balu-16/SeedGrant_Safety/client/assets/illustrations/onboarding-2.png

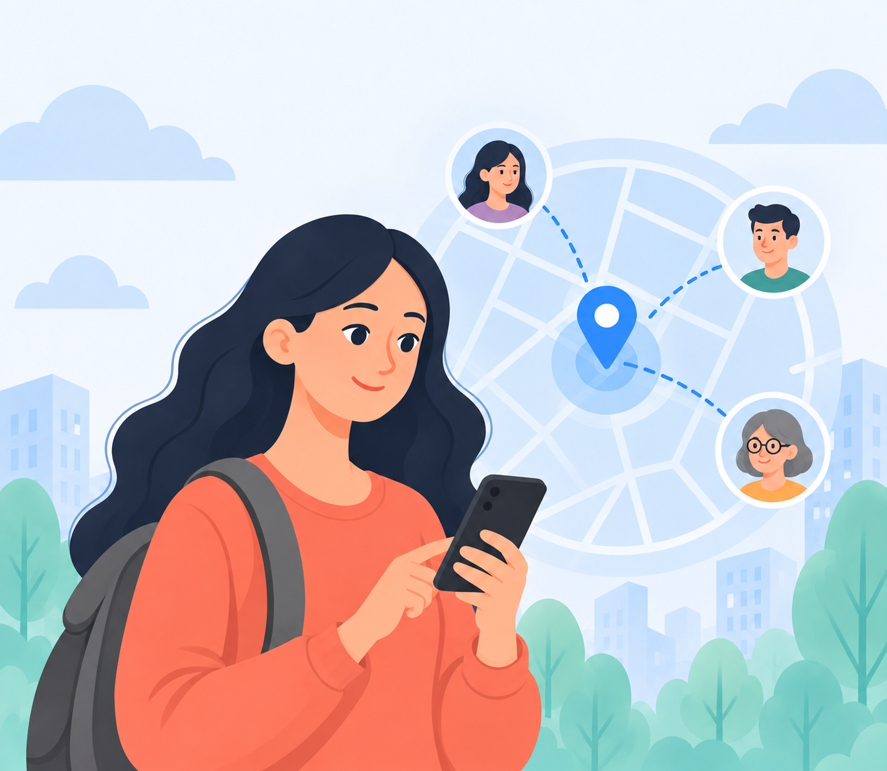
client/assets/illustrations/onboarding-2.png
