balu-16/SeedGrant_Safety/client/assets/illustrations/onboarding-1.png

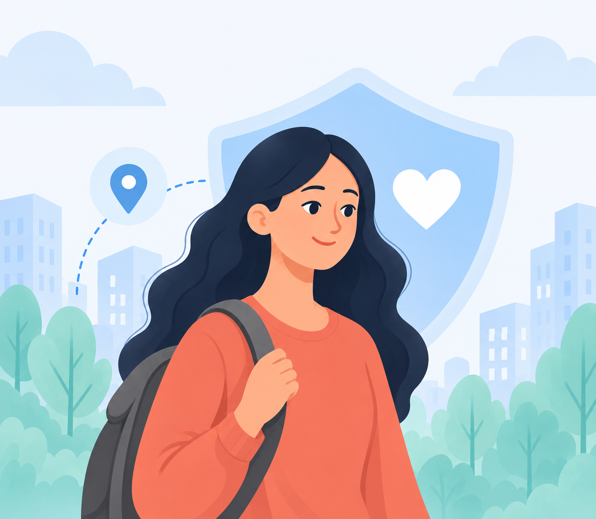
client/assets/illustrations/onboarding-1.png
