balu-16/SeedGrant_Safety/smart-safety-tag-v1/docs/design-inputs.md

# Smart Safety Tag V1 — Design Decisions

The editable KiCad design contains a 60 × 42 mm tag PCB and a 32 × 22 mm charging-adapter PCB. Both boards use two copper layers and 1.0 mm FR-4. The phone supplies location and Internet access. The tag provides BLE, audio capture, motion sensing, a physical SOS button, battery monitoring, RGB status and vibration.

| Function | Final selection | Electrical decision and manufacturer evidence |
| --- | --- | --- |
| MCU and BLE | ESP32-S3-MINI-1-N4R2 | 4 MB flash and 2 MB PSRAM. GPIO26 stays unused because it is reserved by this module option. The local land pattern uses the mechanically compatible ESP32-S2-MINI-1 name; the **symbol and fitted part are ESP32-S3**. [Espressif datasheet](https://documentation.espressif.com/esp32-s3-mini-1_mini-1u_datasheet_en.pdf). |
| PDM microphone | IM67D128BV01 | A switched TPS7A2030 provides 3.0 V. R5/R6 divide the clock into that supply domain. LR is grounded. Capture uses a 2.048 MHz PDM clock and 16 kHz mono PCM. [Infineon datasheet](https://www.infineon.com/assets/row/public/documents/24/49/infineon-im67d128b-datasheet-en.pdf). |
| Motion sensing | LIS2DW12TR | I²C address 0x18; CS high and SA0 low. INT1 and INT2 reach RTC-capable GPIOs. [ST datasheet](https://www.st.com/resource/en/datasheet/lis2dw12.pdf). |
| Battery | Akyga AKY1604 | Protected 400 mAh pack with Molex 51021-0200 lead; PCB connector is 53261-0271. Assembled pack envelope is 37.5 × 31 × 4.5 mm, excluding leads. Charge only within the pack's 0–45 °C range. Verify delivered connector polarity before attachment. [Pack specification](https://elektronik.ropla.eu/pdf/stock/aky/aky1604.pdf), [Molex connector](https://www.molex.com/en-us/products/part-detail/532610271). |
| Charger and power path | BQ25185DLHR | Standalone charger: R7 = 18 kΩ selects 4.2 V and 500 mA input limit; R8 = 2 kΩ sets 150 mA nominal charging. BAT feeds SYS when external power is absent. STAT1/STAT2 are discrete outputs. [TI datasheet](https://www.ti.com/lit/ds/symlink/bq25185.pdf). |
| 3.3 V regulator | TPS63802DLAR | Replaces TPS63031 to provide additional current margin. TPS63031 specifies up to 500 mA in boost operation; the design allocates a 500 mA rail test load. R18/R19 = 511 kΩ/91 kΩ set 3.308 V nominal. MODE defaults low for power saving and goes high while the microphone LDO is enabled. [TPS63031](https://www.ti.com/lit/ds/symlink/tps63030.pdf), [TPS63802](https://www.ti.com/lit/ds/symlink/tps63802.pdf). |
| Inductor | XFL4015-471MEC | 0.47 µH; the XFL4015-471 family appears in TI's recommended inductor table. [Coilcraft specification](https://www.coilcraft.com/getmedia/84927b8b-f089-421b-a7f4-a0fa23afe908/xfl4015.pdf). |
| Fuel gauge | MAX17048G+T10 | Connected to the protected BAT terminals, I²C address 0x36. The alert reaches GPIO5. SOC accuracy and low-battery thresholds require a discharge test with the fitted pack. [ADI datasheet](https://www.analog.com/media/en/technical-documentation/data-sheets/MAX17048-MAX17049.pdf). |
| SOS and status | KMR231GLFS; APFA3010LSEEZGKQBKC | SOS uses GPIO1, a 100 kΩ pull-up and 10 nF filtering, plus firmware debounce. Common-anode RGB uses active-low GPIO outputs and separate resistors. Check brightness through the enclosure. [Switch](https://www.ckswitches.com/media/1479/kmr2.pdf), [LED](https://www.kingbrightusa.com/images/catalog/spec/apfa3010lseezgkqbkc.pdf). |
| Vibration | VC0825B002F; TPS7A2030; AO3400A; PMEG2010EA,115 | Switched 3.0 V motor supply; 120 mA maximum starting-current allocation. Low-side MOSFET has a gate resistor and pull-down; the diode provides flyback protection. The motor is wired to M1 and mechanically retained. [Motor](https://www.vybronics.com/wp-content/uploads/datasheet-files/Vybronics-VC0825B002F-datasheet.pdf), [LDO](https://www.ti.com/lit/ds/symlink/tps7a20.pdf), [MOSFET](https://aosmd.com/res/data_sheets/AO3400A.pdf), [diode](https://assets.nexperia.com/documents/data-sheet/PMEG2010EA.pdf). |
| Contact protection | TPD1E10B06DYAR; PMEG6010CEH,115 | TPD1E10B06 replaces the proposed ESD5Z5.0T1G: its 5.5 V working range covers a normal 5 V ±5% source. The series Schottky blocks reversed charging polarity. Exposed-source short protection is on the adapter. [ESD device](https://www.ti.com/lit/ds/symlink/tpd1e10b06.pdf), [series diode](https://assets.nexperia.com/documents/data-sheet/PMEG6010CEH.pdf). |
| Charging adapter | USB4125-GF-A; TPS259530DSGR; Mill-Max 0900-1-15-20-75-14-11-0 | Separate 5.1 kΩ CC resistors; power-only USB-C. A 2.8 kΩ ILIM resistor sets approximately 0.754 A. The eFuse sits before the exposed pogo pins. Its overvoltage clamp is 5.45 V typical, 5.7 V maximum. [GCT drawing](https://gct.co/files/drawings/usb4125.pdf), [eFuse](https://www.ti.com/lit/ds/symlink/tps2595.pdf), [spring-pin catalog](https://www.mill-max.com/sites/default/files/external/catalog/2021-02/023-028.pdf). |

The exact passive order codes, voltage ratings and purchasing quantities are in the generated BOMs. Resistors are 1% Yageo RC0603 parts; capacitors are the listed TDK parts. Purchasing availability can change, so substitute parts require another voltage, capacitance, package and layout review.

C13 uses a 22 µF/16 V 1206 C3216X5R1C226M160AB. It replaces the initial 10 µF/25 V 0805 input capacitor after its manufacturer DC-bias curve showed insufficient derating margin near the charger's 4.5 V SYS rail. The larger capacitor's footprint fits the regulator area. The numerical allowance and remaining physical qualification are recorded in [power-budget.md](power-budget.md).

The battery-temperature circuit uses RT1 = B57332V5103A260, a 10 kΩ B3435 NTC, on the rear PCB face. **RT1 must be thermally bonded to the cell using an insulating interface that distributes pressure.** Its placement inside the battery envelope does not establish thermal contact. A TLV7042 window pulls CHG_OK low on a temperature fault, turns Q1 off and lets R16 drive charger /CE high. GPIO16 can also inhibit charging through Q2; it cannot override a hardware fault. The modeled corner check covers resistor/NTC tolerances, charger bias, supply variation, comparator offset and hysteresis. Open/short fault response and thermal lag still require measurements. [Comparator datasheet](https://www.ti.com/lit/ds/symlink/tlv7032.pdf).

The module antenna projects 3.75 mm beyond the board's top edge. Its all-layer copper, track, via and component keepout remains in the PCB. Keep the battery, metal clip and magnets outside that region. The bottom-port microphone uses the specified 0.4 mm unplated acoustic hole. Its enclosure needs an aligned acoustic opening and a suitable seal. The selected battery outline, lead exit, button travel, LED view, motor support, cell insulation and pogo compression must be checked in a physical enclosure mockup before freezing a wearable product.

The hardware supports continuous PDM capture while the MCU is awake. Keyword inference, phone emergency messaging and product firmware are separate from the included hardware-test application. Continuous keyword detection is **not available in deep sleep** in this design.
