balu-16/SeedGrant_Safety/client/assets/illustrations/PROMPTS.md

# Illustration generation

Built-in image_gen tool. Original reference images preserved in reference/. Card 2 received an anatomical correction before acceptance.

## prompt1

Use case: precise-object-edit. Create a standalone onboarding illustration asset from reference image 1 (SplashCard1); reference image 2 (SplashCard3) is the exact girl's identity and OPEN EYES reference. Output ONLY the illustrated scene, landscape ratio about 1.15:1, no phone frame, no UI, no branding, headings, buttons, or typography. Closely preserve the original soft clean 2D illustration, warm peach skin, long wavy dark navy hair, coral long sleeve top, gray backpack, pose holding shoulder strap, blue shield with white heart behind her, pale blue city and mint trees, location pin. Open both her eyes naturally, matching SplashCard3. REMOVE the black oval tag AND its metal clip from the bag/strap entirely; reconstruct a plain continuous gray backpack strap. No tag, tracker, hanging accessory, clip or keychain anywhere. Keep face identity, pleasant smile, hair, clothing and scene composition faithful. Pale near-white #F5F9FF background, full-bleed illustrated landscape with character ending at bottom edge, no white curved UI panel. High quality crisp asset for mobile.

## prompt2

Use case: precise-object-edit. Output a standalone mobile onboarding scene illustration ONLY, landscape ratio 1.15:1. Image 1 is SplashCard2 composition reference; image 2 is approved character identity, exact rendering style and open-eyes reference. Faithfully recreate the illustrated scene from card 2: same girl long wavy navy hair, warm peach skin, coral long-sleeve top, gray backpack, using black phone; pale blue circular street map behind her at right with blue location marker connected by dotted blue lines to three circular guardian portraits, mint trees and faint city, clouds. Open both girl's eyes naturally with exact style from image 2, looking at phone, retain pleasant smile. REMOVE black oval safety tag and all hanging clips/accessories from bag shoulder strap, restore plain gray continuous strap. Do not put a tag elsewhere. Preserve original pose/composition and character consistency. NO phone bezel, app text, logos, heading, buttons, status bar, footer, or UI panels. Near-white #F5F9FF background, crisp soft 2D editorial illustration, full-bleed scene, girl ends at bottom edge.

## prompt2fix

Precise-object-edit. Fix ONLY the anatomical defect in this illustration. The girl currently has three hands. REMOVE entirely the hand gripping the backpack shoulder strap and its forearm, reconstruct her coral shirt and plain uninterrupted gray backpack strap there. She must have EXACTLY TWO arms and TWO hands: one hand holding the black phone, the other index finger tapping the phone. Make their sleeves and arms connect anatomically naturally to her shoulders. Preserve her face, both open eyes, smile, navy hair, same coral clothing, backpack, map, guardians portraits, colors, soft illustration style, framing and every background detail. No tag, no clip, no hanging device. Output entire corrected standalone illustration.

## prompt3

Use case: precise-object-edit. Generate standalone illustration scene for onboarding card 3. Image 1 SplashCard3 is composition reference, image 2 is approved matching character/style reference. ONLY illustration, landscape 1.15:1, no phone bezel, app heading/branding/buttons/status bar/footer or UI panels. Same warm peach-skinned girl, long wavy dark navy hair, coral long sleeve shirt and gray backpack, open eyes looking at black phone and pleasant smile, exactly two anatomically correct arms/hands: holding phone and tapping. Faithfully preserve scene: pale blue city and mint trees, clouds; coral circular SOS symbol to right upper side, blue dotted lines connect it to three circular friendly guardian portraits on right, subtle coral alert rays. SOS is the only text. Remove black oval tracker tag AND metal clip completely from backpack strap, reconstruct plain gray strap. No device, accessory or clip attached to bag anywhere. Match reference 2's exact face, hair, rendering softness, palette, and clean 2D illustration style. Full-bleed near-white #F5F9FF background with character ending at bottom edge.
