balu-16/SeedGrant_Safety/client/assets/illustrations/SUPPORTING-PROMPTS.md

## Guardians hero

Create a standalone compact horizontal illustration asset from the GuardiansPage reference (image 1). Image 2 is exact approved main girl identity and style reference. Output only three friendly people waist-up as in GuardiansPage hero: navy-haired young man blue shirt left, main girl long wavy navy hair coral shirt center, young woman dark hair purple shirt right, arranged as a close trusted safety circle. All eyes open, main girl's face and rendering match image 2 exactly. Soft pale-blue shield-heart behind group, light blue clouds and very pale background #F5F9FF. Clean soft 2D illustration. Wide 2:1 crop, people fill central 75 percent of frame, bottom cropped at torso. No bag tags or device attachments. No typography, no slogans, no labels, no UI, no phone frame, no contact cards.

## Demo profile avatar

Create a standalone square profile avatar photograph inspired by the small profile photo in the attached UI reference. A fictional friendly young adult Indian woman, warm medium-brown skin, long dark brown hair, brown eyes open, natural smile, simple cream top. Head and shoulders centered, face large enough for a 48px circular avatar. Soft even studio lighting, plain light blue-gray background. Realistic photograph, clean polished professional profile portrait. ONLY portrait, no UI, text, border or phone frame.
