balu-16/SeedGrant_Safety/journal/ieee/figures/architecture.pdf

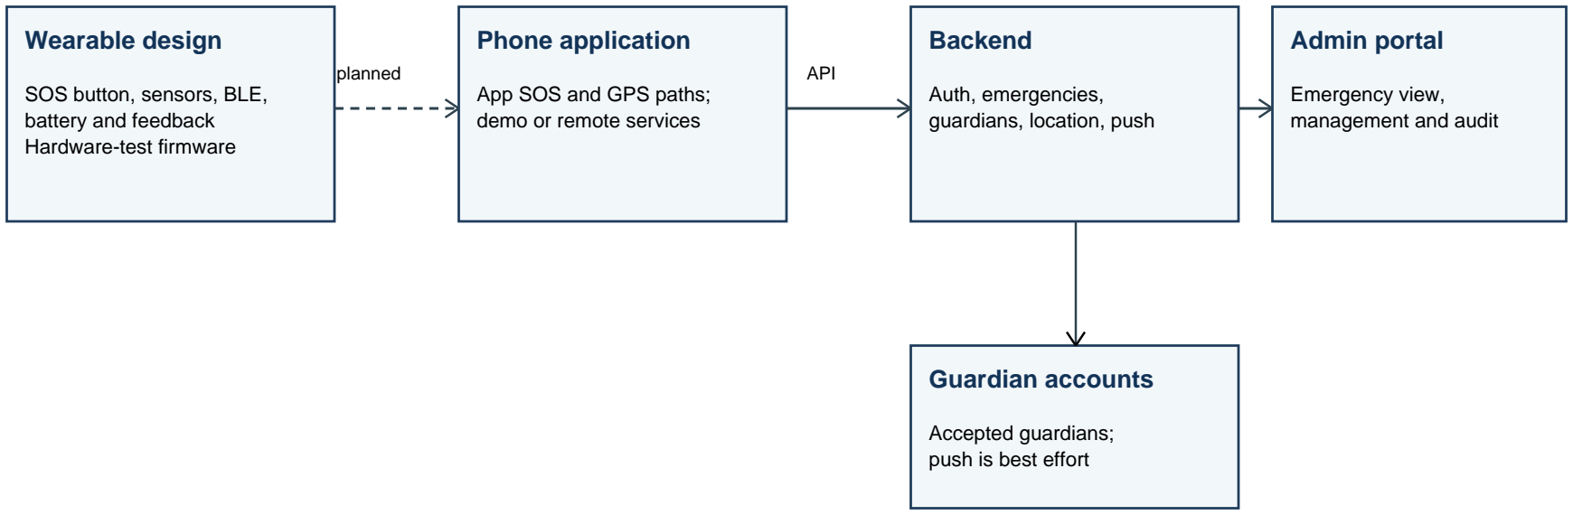
[picture p3: figure]
Wearable design; SOS button, sensors, BLE, battery and feedback Hardware-test firmware; Phone application; App SOS and GPS paths; demo or remote services; Backend; Auth, emergencies, guardians, location, push; Admin portal; Emergency view, management and audit; planned; API; Guardian accounts; Accepted guardians; push is best effort

Solid links: implemented software paths. Dashed link: intended integration, not implemented.
