balu-16/SeedGrant_Safety/patent/README.md

# Smart Safety Tag invention disclosure

`Patent.docx` is the editable document, copied and adapted from `/home/balarakeshg16/Documents/Projects/IDP_Project/Patent.docx`. `invention_disclosure.docx` is an identical copy retained for the earlier link, and `invention_disclosure.pdf` is its rendered PDF. The original IDP document has not been changed. The template's questions, tables, styles, headers, names, roll numbers, guide and signature images are preserved. Following the user's instruction, signature dates are set to 29.10.2026. Project-specific contributions and disclosure history remain for the team to confirm.

`adapt_reference.py` uses python-docx 1.2.0, the reference DOCX and the images in `figures/` to regenerate `Patent.docx`. `figures/make_figures.py` uses PyMuPDF to regenerate the diagrams; the other images are demo-mode app screenshots. The previous `create_docx.py`, `invention_disclosure.html`, and `architecture.png` are retained as superseded materials and should not be used to regenerate the current document.

The document is an invention disclosure rather than a patent application. Prior-art entries are preliminary and no patentability or formal similarity assessment is claimed.
