balu-16/SeedGrant_Safety/client/assets/illustrations/guardians.png

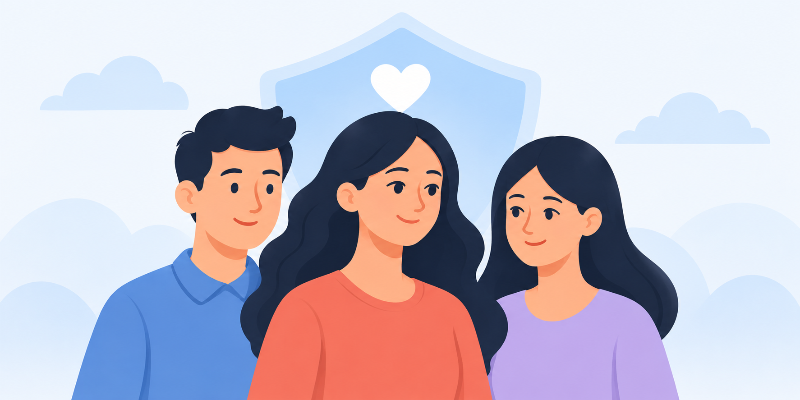
client/assets/illustrations/guardians.png
