balu-16/SeedGrant_Safety/client/assets/illustrations/onboarding-3.png

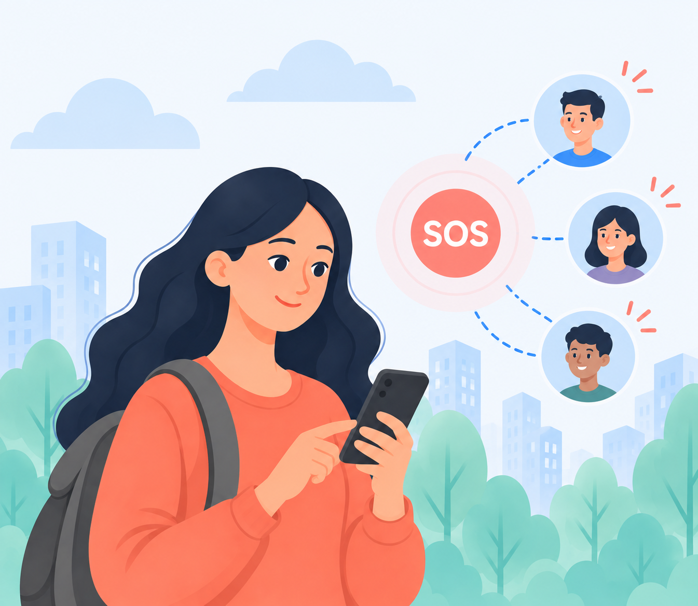
client/assets/illustrations/onboarding-3.png
