balu-16/SeedGrant_Safety/journal/ieee/figures/architecture.png

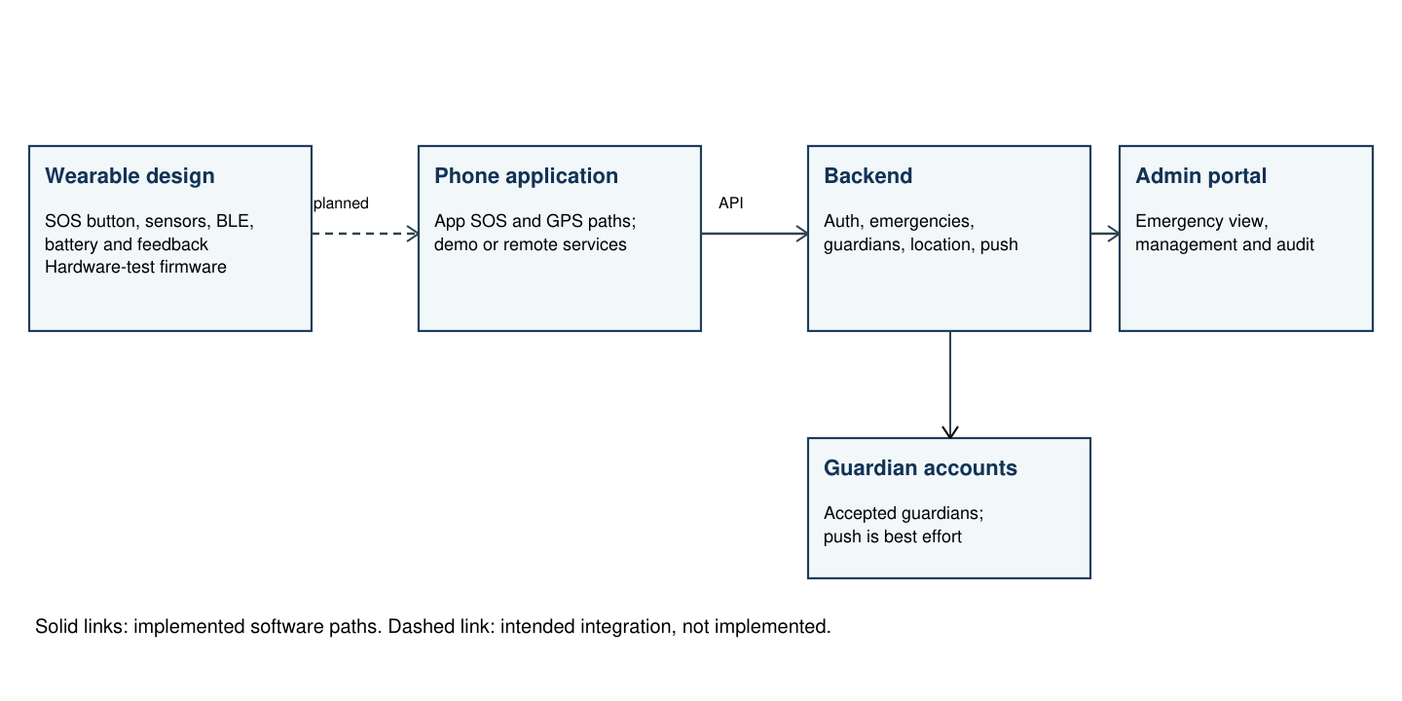
journal/ieee/figures/architecture.png
