balu-16/SeedGrant_Safety/patent/figures/fig1.png

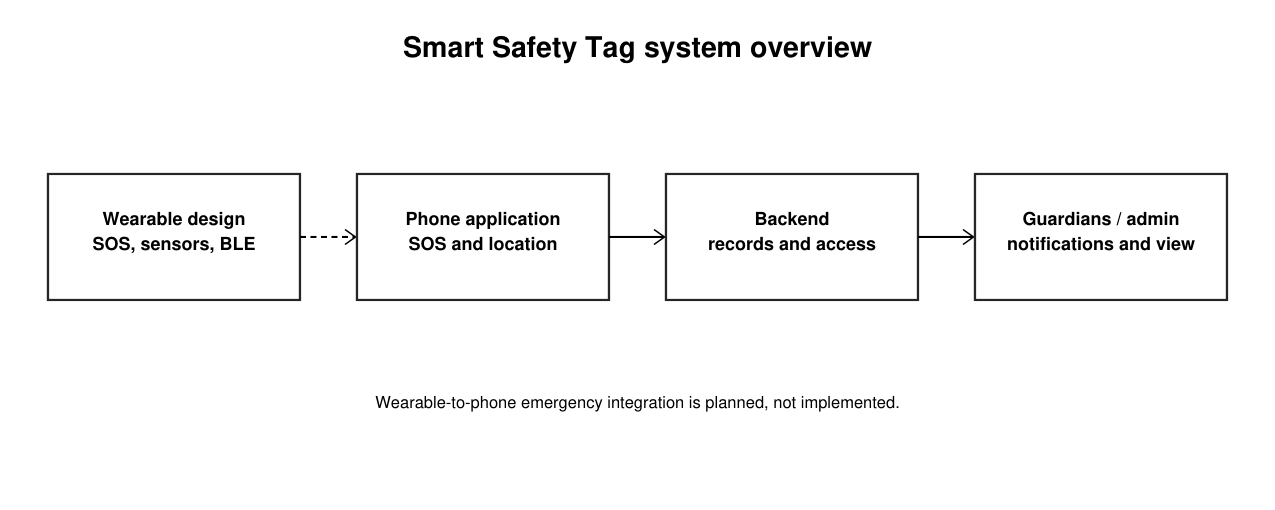
patent/figures/fig1.png
