balu-16/SeedGrant_Safety/patent/figures/guardians.png

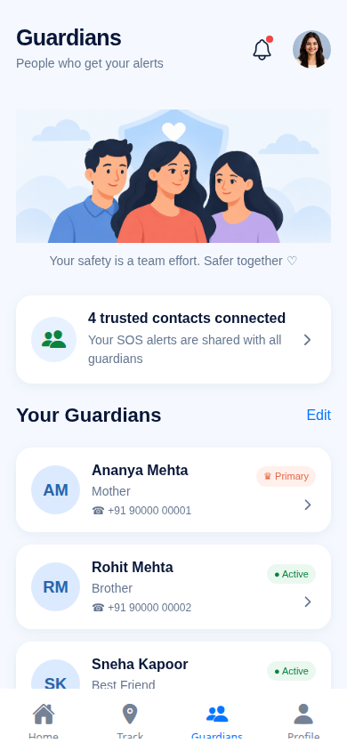
patent/figures/guardians.png
