balu-16/SeedGrant_Safety/patent/figures/home.png

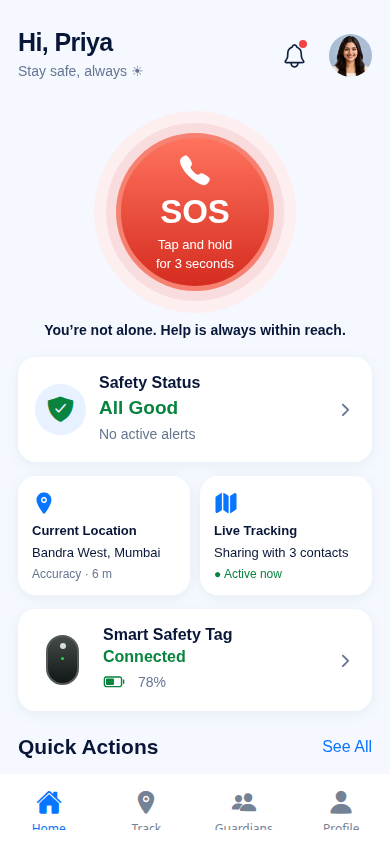
patent/figures/home.png
