balu-16/SeedGrant_Safety/patent/figures/login.png

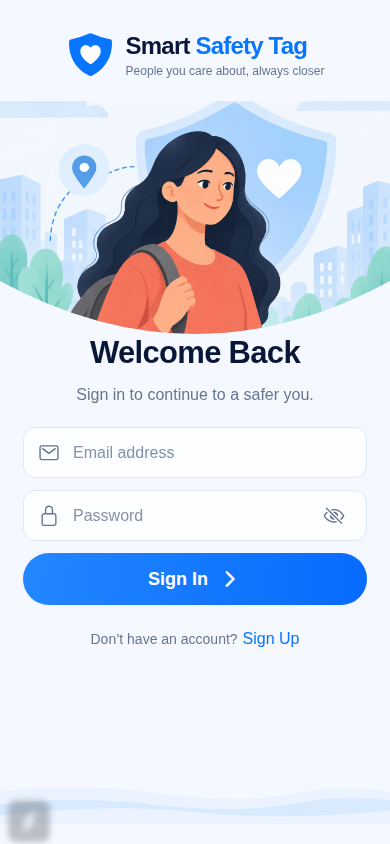
patent/figures/login.png
