balu-16/SeedGrant_Safety/patent/figures/signup.png

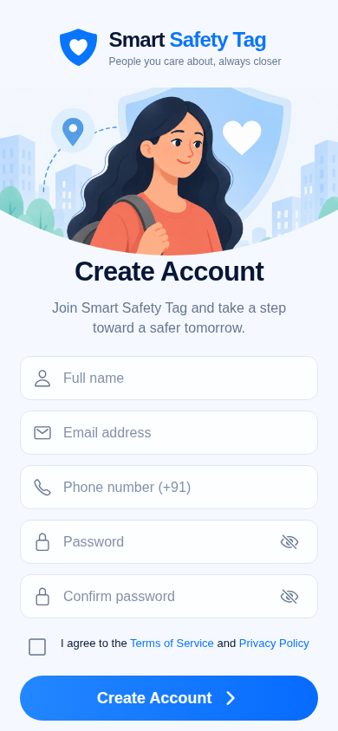
patent/figures/signup.png
