balu-16/SeedGrant_Safety/patent/figures/track.png

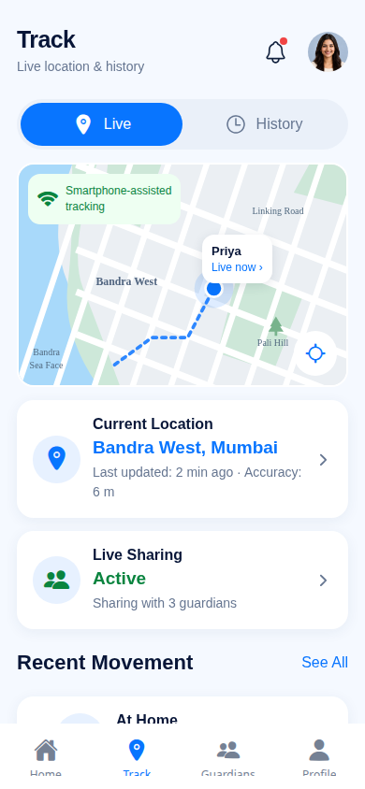
patent/figures/track.png
