balu-16/SeedGrant_Safety/reference/GuardiansPage.png

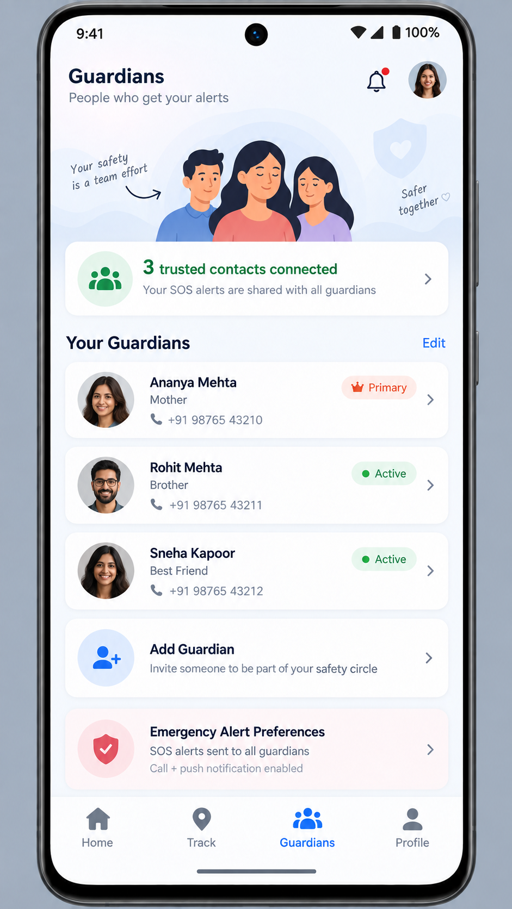
reference/GuardiansPage.png
