balu-16/SeedGrant_Safety/reference/HomePage.png

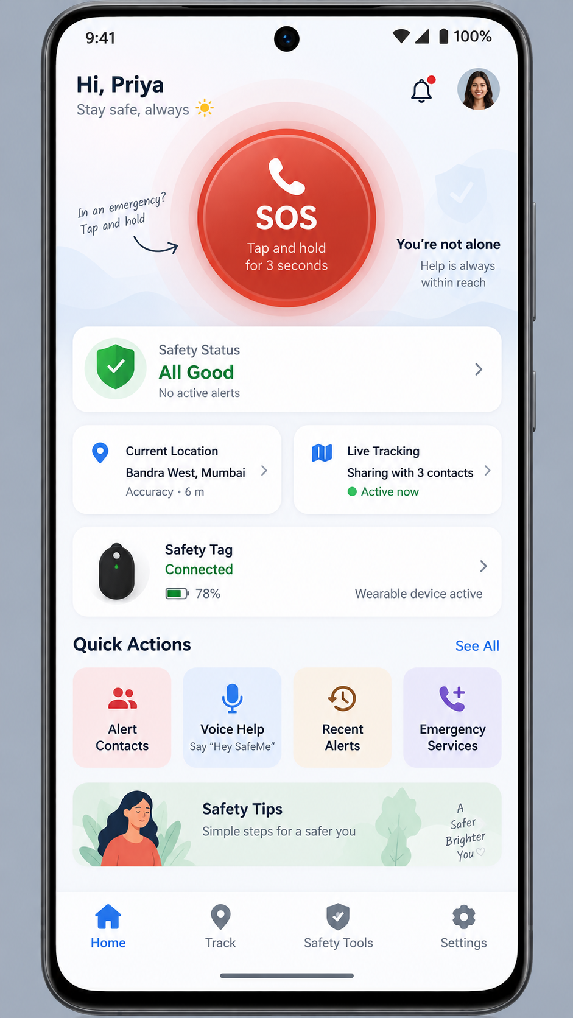
reference/HomePage.png
