balu-16/SeedGrant_Safety/reference/LoginPage.png

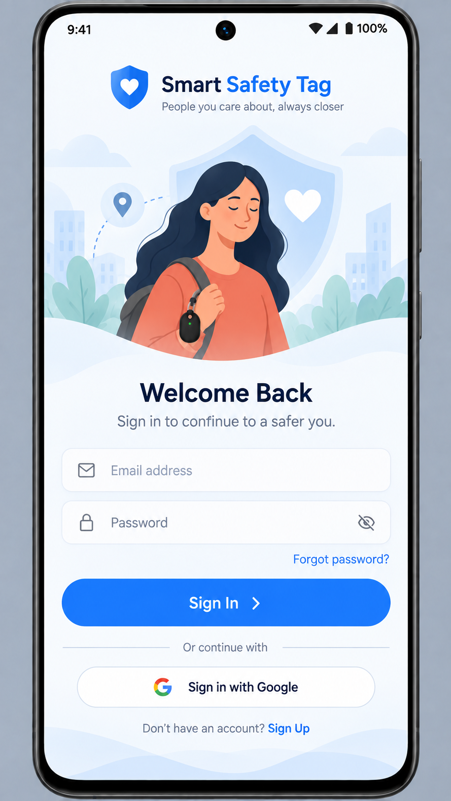
reference/LoginPage.png
