balu-16/SeedGrant_Safety/reference/ProfilePage.png

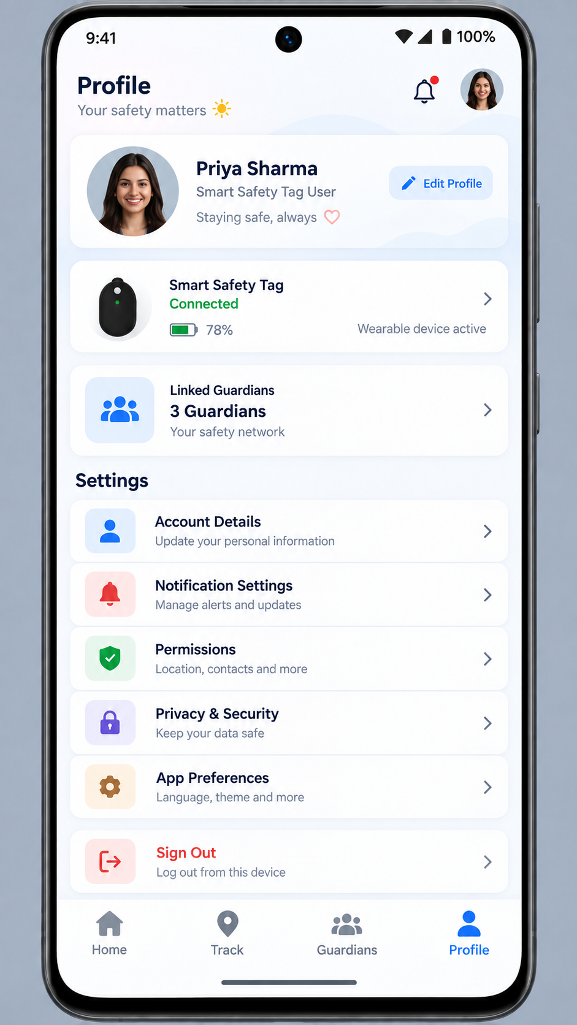
reference/ProfilePage.png
