balu-16/SeedGrant_Safety/reference/SignupPagee.png

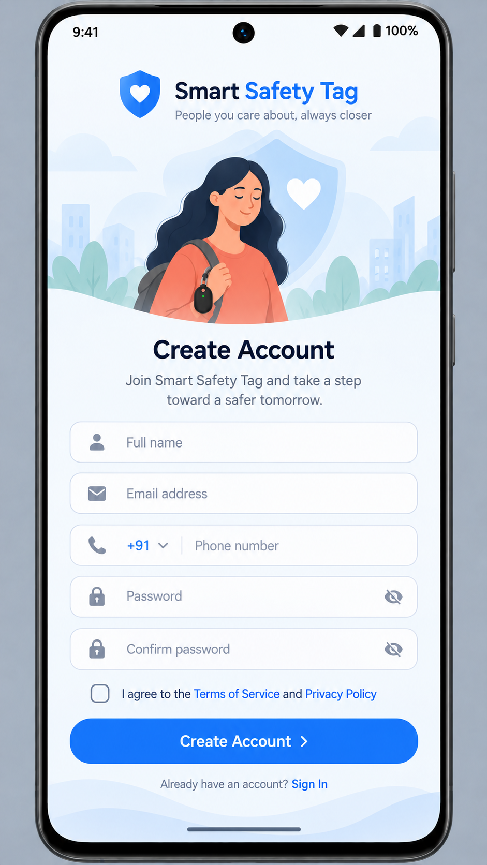
reference/SignupPagee.png
