balu-16/SeedGrant_Safety/reference/TrackPage.png

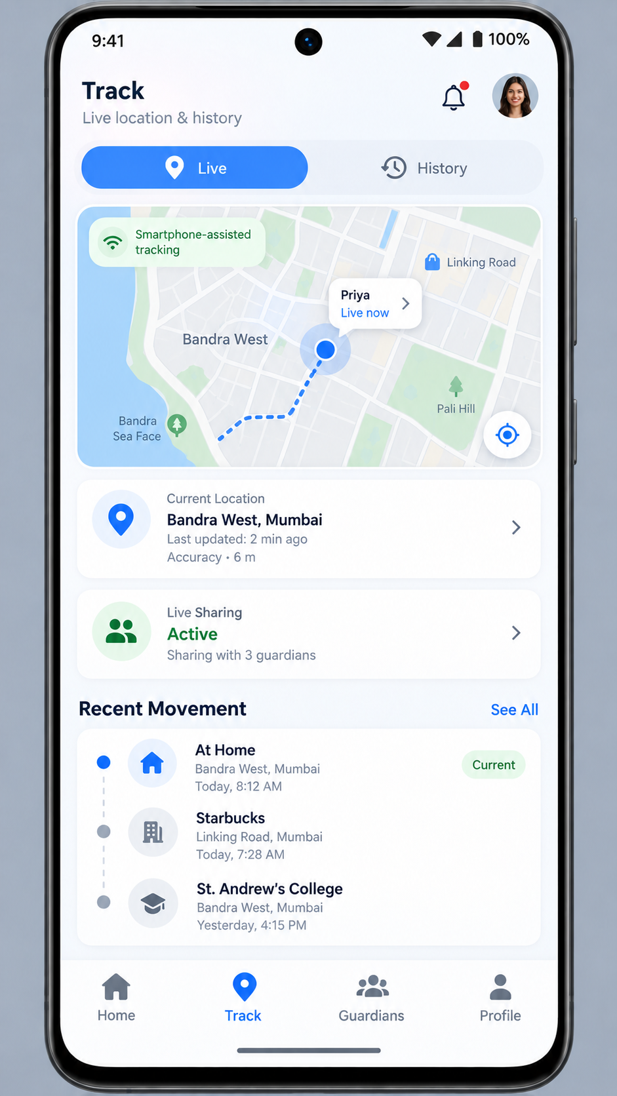
reference/TrackPage.png
