balu-16/SeedGrant_Safety/smart-safety-tag-v1/manufacturing/tag/bom/tag-bom.csv

References | Quantity | Manufacturer | Manufacturer Part Number | Value / Description | Package / PCB Footprint | Assembly | Manufacturer Source
BAT1 | 1 | Akyga | AKY1604 | Protected 400 mAh Li-polymer pack; Molex 51021-0200 lead | LP403035, cell 4.0 x 30 x 37 mm; assembled 4.5 x 31 x 37.5 mm | Attach to J1 after PCB electrical checks | https://elektronik.ropla.eu/pdf/stock/aky/aky1604.pdf
C1 C10 C13 C14 C15 | 5 | TDK | C3216X5R1C226M160AB | 22uF 16V X5R | Safety:C_1206_3216Metric | PCB placement | https://product.tdk.com/en/search/capacitor/ceramic/mlcc/info?part_no=C3216X5R1C226M160AB
C17 | 1 | TDK | C1608X7R1H103K080AA | 10nF 50V X7R | Safety:C_0603_1608Metric | PCB placement | https://product.tdk.com/en/search/capacitor/ceramic/mlcc/info?part_no=C1608X7R1H103K080AA
C19 | 1 | TDK | C1608X5R1A475K080AE | 4.7uF 10V X5R | Safety:C_0603_1608Metric | PCB placement | https://product.tdk.com/en/search/capacitor/ceramic/mlcc/info?part_no=C1608X5R1A475K080AE
C2 C7 C12 C16 C20 C23 | 6 | TDK | C1608X7R1H104K080AA | 100nF 50V X7R | Safety:C_0603_1608Metric | PCB placement | https://product.tdk.com/en/search/capacitor/ceramic/mlcc/info?part_no=C1608X7R1H104K080AA
C3 C4 C5 C6 C11 C18 C22 C25 C26 C27 | 10 | TDK | C1608X7R1C105K080AC | 1uF 16V X7R | Safety:C_0603_1608Metric | PCB placement | https://product.tdk.com/en/search/capacitor/ceramic/mlcc/info?part_no=C1608X7R1C105K080AC
C8 C21 C24 | 3 | TDK | C2012X5R1E106K125AB | 10uF 25V X5R | Safety:C_0805_2012Metric | PCB placement | https://product.tdk.com/en/search/capacitor/ceramic/mlcc/info?part_no=C2012X5R1E106K125AB
C9 | 1 | TDK | C1608X7R1E105K080AE | 1uF 25V X7R | Safety:C_0603_1608Metric | PCB placement | https://product.tdk.com/en/search/capacitor/ceramic/mlcc/info?part_no=C1608X7R1E105K080AE
D1 | 1 | Texas Instruments | TPD1E10B06DYAR | TPD1E10B06DYAR | Safety:D_SOD-523 | PCB placement | https://www.ti.com/lit/ds/symlink/tpd1e10b06.pdf
D2 | 1 | Nexperia | PMEG6010CEH,115 | PMEG6010CEH | Safety:D_SOD-123F | PCB placement | https://assets.nexperia.com/documents/data-sheet/PMEG6010CEH.pdf
D3 | 1 | Kingbright | APFA3010LSEEZGKQBKC | APFA3010LSEEZGKQBKC | Safety:LED_Kingbright_APFA3010_3x1.5mm_Horizontal | PCB placement | https://www.kingbrightusa.com/images/catalog/spec/apfa3010lseezgkqbkc.pdf
D4 | 1 | Nexperia | PMEG2010EA,115 | PMEG2010EA | Safety:D_SOD-323 | PCB placement | https://assets.nexperia.com/documents/data-sheet/PMEG2010EA.pdf
J1 | 1 | Molex | 53261-0271 | AKY1604 protected pack | Safety:Molex_PicoBlade_53261-0271_1x02-1MP_P1.25mm_Horizontal | PCB placement | https://www.molex.com/en-us/products/part-detail/532610271
L1 | 1 | Coilcraft | XFL4015-471MEC | 0.47uH 5.4A at 20% drop | Safety:L_Coilcraft_XFL4015 | PCB placement | https://www.coilcraft.com/getmedia/84927b8b-f089-421b-a7f4-a0fa23afe908/xfl4015.pdf
M1 | 1 | Vybronics | VC0825B002F | VC0825B002F | Safety:Motor_VC0825B002F | Wire to PCB pads | https://www.vybronics.com/wp-content/uploads/datasheet-files/Vybronics-VC0825B002F-datasheet.pdf
Q1 Q2 | 2 | Nexperia | BSS138P,215 | BSS138P | Safety:SOT-23 | PCB placement | https://assets.nexperia.com/documents/data-sheet/BSS138P.pdf
Q3 | 1 | Alpha & Omega Semiconductor | AO3400A | AO3400A | Safety:SOT-23 | PCB placement | https://aosmd.com/res/data_sheets/AO3400A.pdf
R1 R2 R6 R9 R10 R21 R22 | 7 | Yageo | RC0603FR-0710KL | 10k 1% | Safety:R_0603_1608Metric | PCB placement | https://www.yageogroup.com/component-documentation/download/specsheet/RC0603FR-0710KL
R11 | 1 | Yageo | RC0603FR-07432KL | 432k 1% | Safety:R_0603_1608Metric | PCB placement | https://www.yageogroup.com/component-documentation/download/specsheet/RC0603FR-07432KL
R12 | 1 | Yageo | RC0603FR-0724K9L | 24.9k 1% | Safety:R_0603_1608Metric | PCB placement | https://www.yageogroup.com/component-documentation/download/specsheet/RC0603FR-0724K9L
R13 | 1 | Yageo | RC0603FR-07365KL | 365k 1% | Safety:R_0603_1608Metric | PCB placement | https://www.yageogroup.com/component-documentation/download/specsheet/RC0603FR-07365KL
R14 | 1 | Yageo | RC0603FR-0749K9L | 49.9k 1% | Safety:R_0603_1608Metric | PCB placement | https://www.yageogroup.com/component-documentation/download/specsheet/RC0603FR-0749K9L
R15 R17 R20 R23 R28 | 5 | Yageo | RC0603FR-07100KL | 100k 1% | Safety:R_0603_1608Metric | PCB placement | https://www.yageogroup.com/component-documentation/download/specsheet/RC0603FR-07100KL
R16 | 1 | Yageo | RC0603FR-0747KL | 47k 1% | Safety:R_0603_1608Metric | PCB placement | https://www.yageogroup.com/component-documentation/download/specsheet/RC0603FR-0747KL
R18 | 1 | Yageo | RC0603FR-07511KL | 511k 1% | Safety:R_0603_1608Metric | PCB placement | https://www.yageogroup.com/component-documentation/download/specsheet/RC0603FR-07511KL
R19 | 1 | Yageo | RC0603FR-0791KL | 91k 1% | Safety:R_0603_1608Metric | PCB placement | https://www.yageogroup.com/component-documentation/download/specsheet/RC0603FR-0791KL
R25 R26 | 2 | Yageo | RC0603FR-07330RL | 330R 1% | Safety:R_0603_1608Metric | PCB placement | https://www.yageogroup.com/component-documentation/download/specsheet/RC0603FR-07330RL
R27 | 1 | Yageo | RC0603FR-07100RL | 100R 1% | Safety:R_0603_1608Metric | PCB placement | https://www.yageogroup.com/component-documentation/download/specsheet/RC0603FR-07100RL
R3 R4 | 2 | Yageo | RC0603FR-074K7L | 4.7k 1% | Safety:R_0603_1608Metric | PCB placement | https://www.yageogroup.com/component-documentation/download/specsheet/RC0603FR-074K7L
R5 R24 | 2 | Yageo | RC0603FR-071KL | 1k 1% | Safety:R_0603_1608Metric | PCB placement | https://www.yageogroup.com/component-documentation/download/specsheet/RC0603FR-071KL
R7 | 1 | Yageo | RC0603FR-0718KL | 18k 1% | Safety:R_0603_1608Metric | PCB placement | https://www.yageogroup.com/component-documentation/download/specsheet/RC0603FR-0718KL
R8 | 1 | Yageo | RC0603FR-072KL | 2k 1% | Safety:R_0603_1608Metric | PCB placement | https://www.yageogroup.com/component-documentation/download/specsheet/RC0603FR-072KL
RT1 | 1 | TDK | B57332V5103A260 | 10k B3435 1% | Safety:R_0603_1608Metric | PCB placement | https://www.tdk-electronics.tdk.com/en/530404/products/product-catalog/sensors-and-sensor-systems/smd-ntc-thermistors
SW1 | 1 | C&K | KMR231GLFS | SOS | Safety:SW_Push_1P1T-SH_NO_CK_KMR2xxG | PCB placement | https://www.ckswitches.com/media/1479/kmr2.pdf
U1 | 1 | Espressif | ESP32-S3-MINI-1-N4R2 | ESP32-S3-MINI-1-N4R2 | Safety:ESP32-S2-MINI-1 | PCB placement | https://documentation.espressif.com/esp32-s3-mini-1_mini-1u_datasheet_en.pdf
U2 | 1 | Infineon | IM67D128BV01 | IM67D128BV01 | Safety:Infineon_IM67D128BV01 | PCB placement | https://www.infineon.com/assets/row/public/documents/24/49/infineon-im67d128b-datasheet-en.pdf
U3 U9 | 2 | Texas Instruments | TPS7A2030PDBVR | TPS7A2030PDBVR | Safety:SOT-23-5 | PCB placement | https://www.ti.com/lit/ds/symlink/tps7a20.pdf
U4 | 1 | STMicroelectronics | LIS2DW12TR | LIS2DW12 | Safety:LGA-12_2x2mm_P0.5mm | PCB placement | https://www.st.com/resource/en/datasheet/lis2dw12.pdf
U5 | 1 | Texas Instruments | BQ25185DLHR | BQ25185DLHR | Safety:Texas_DLH0010A_WSON-10-1EP_2.2x2mm_P0.4mm_EP0.9x1.5mm | PCB placement | https://www.ti.com/lit/ds/symlink/bq25185.pdf
U6 | 1 | Texas Instruments | TLV7042DDFR | TLV7042DDFR | Safety:SOT-23-8 | PCB placement | https://www.ti.com/lit/ds/symlink/tlv7032.pdf
U7 | 1 | Texas Instruments | TPS63802DLAR | TPS63802DLAR | Safety:Texas_DLA0010A_VSON-10_2x3mm | PCB placement | https://www.ti.com/lit/ds/symlink/tps63802.pdf
U8 | 1 | Analog Devices | MAX17048G+T10 | MAX17048G+T10 | Safety:TDFN-8-1EP_2x2mm_P0.5mm_EP0.8x1.2mm | PCB placement | https://www.analog.com/media/en/technical-documentation/data-sheets/MAX17048-MAX17049.pdf
