balu-16/SeedGrant_Safety/smart-safety-tag-v1/docs/verification.md

# Smart Safety Tag V1 — Verification Register

CAD checks, calculations and firmware compilation are recorded separately from physical measurements. No assembled prototype was available for this design run. The current release is a prototype fabrication package.

| Check | Evidence | Result and limit |
| --- | --- | --- |
| Manufacturer pin/package review | Exact order codes and manufacturer links in [design-inputs.md](design-inputs.md), project-local symbols/land patterns and procurement BOMs | Design reviewed against the referenced package/pin information. Assembly inspection remains required; ERC cannot prove a manufacturer's pin mapping. |
| Tag schematic ERC | [hardware/tag/erc-report.txt](../hardware/tag/erc-report.txt) | KiCad 10.0.6, all severities: zero violations. Eight native child sheets plus the root. |
| Adapter schematic ERC | [hardware/charging-adapter/erc-report.txt](../hardware/charging-adapter/erc-report.txt) | KiCad 10.0.6, all severities: zero violations. |
| Tag PCB DRC/connectivity | [hardware/tag/routed-drc.json](../hardware/tag/routed-drc.json) | Zero violations, zero unconnected items, zero schematic parity findings after zone refill. 83 footprints. |
| Adapter PCB DRC/connectivity | [hardware/charging-adapter/routed-drc.json](../hardware/charging-adapter/routed-drc.json) | Zero violations, zero unconnected items, zero schematic parity findings after zone refill. 16 footprints. |
| Check coverage and exclusions | Native project settings and exported reports | All PCB DRC rule categories are enabled as errors or warnings, and no DRC item exclusions are recorded. There are no ERC item exclusions. KiCad's default ERC configuration ignores four diagnostics: single-use global labels, four-way junctions, SPICE model issues and symbol/footprint filter mismatch. The report explicitly lists these; zero ERC messages does not mean those categories were evaluated. |
| GPIO/module allocation | `python3 scripts/generate_gpio_header.py`; [GPIO map](gpio-map.md) | Twenty interface assignments match the actual ESP32-S3 module symbol's pad/GPIO names and central net definitions. Boot/reserved GPIO constraints are documented. |
| Thermal electrical model | `python3 scripts/check_thermal_window.py` | Modeled corners inhibit charging at 0 °C and 45 °C and permit it at 25 °C. Includes 1% resistors/NTC R25/beta, 36.5–39.5 µA TS bias, 4.25–5.10 V IN and TLV7042's maximum 8 mV offset/25 mV hysteresis. It does not establish actual threshold accuracy, thermal coupling, lag or fault behavior. |
| Battery/converter allocation | [power-budget.md](power-budget.md) | Nominal 3.308 V, 500 mA 3V3 test allocation, approximately 0.77 A discharge-end battery scenario and estimated runtimes. These are calculations/assumptions, not measured performance. |
| Power trace geometry | [power-routing.json](power-routing.json) and native PCB | Supply traces widened where pad/track clearance permits; narrower fanouts retained where necessary. Final DRC includes these widths. Actual rail loss, transient droop and heating require measurements. |
| Antenna/acoustic CAD provisions | U1 all-layer antenna keepout and U2 footprint/acoustic drill | Keepout retained with 3.75 mm antenna overhang; 0.40 mm unplated microphone opening retained. Battery/clip/magnet/enclosure effects remain unmeasured. |
| Fabrication specification | [manufacturing-specification.md](manufacturing-specification.md), PCB stackup and Gerber jobs | Two copper layers, 1.0 mm thickness and ENIG specified. The USB connector's 1.0 ±0.10 mm thickness constraint is included. Fabricator/assembler CAM review remains required. |
| Hardware-test firmware compilation | [prebuilt/build-record.json](../firmware/hardware-tests/prebuilt/build-record.json) | Successful ESP-IDF v5.5 build for ESP32-S3, GCC 14.2.0. Application image: 582,816 bytes; fits its 1,048,576-byte partition. Source and image SHA-256 hashes supplied. Not flashed to a tag. |
| Export/source correspondence | Manufacturing `manifest.json` for each board | Exact BOMs, Gerbers, drills, placement CSVs and assembly/schematic PDFs regenerated only after the strict checks pass. Manifests include hierarchical sheets, project settings and local libraries. |

The thermal model uses the beta equation and a simplified comparator uncertainty allowance; the actual comparator offset over the chosen low common-mode region, NTC temperature curve, bias accuracy, supply transients and hysteresis must be evaluated on the board. Conservative electrical thresholds can reduce the usable charging temperature window. RT1 must sense the cell through the specified insulating thermal bond.

Physical acceptance work is specified in [bring-up.md](bring-up.md): converter startup/ripple/load steps; capacitor effective capacitance/stability; battery/PCM peak load and cutoff; charge regulation/termination/power-path supplement; thermal lag and open/short NTC response; eFuse, contact reversal/short and ESD; motor startup/flyback; microphone audio quality; SOS/motion wake; BLE range/reconnect; SOC accuracy and runtime; and enclosure/clip/contact/acoustic fit. Record actual conditions and measurements here before changing any of those checks to passed.

The hardware-test firmware keeps the MCU awake. It provides PDM capture and standard BLE advertising, but does not contain an emergency keyword model, phone alert workflow, custom SOS GATT service or sleep/wake implementation. These behaviors and any safety performance claim remain outside the completed CAD/build checks.
