balu-16/SeedGrant_Safety/journal/ieee/REVISION_2_CHANGELOG.md

# Smart Safety Tag: second-pass revision

This pass starts from the previously revised manuscript. The earlier REVISION_CHANGELOG.md and REVISION.diff remain available; REVISION_2.diff compares the manuscript immediately before and after this pass.

## Diagnosis

The current prose was reviewed for repetition, generic explanations and uniform sentence patterns. This ranking is an editorial judgment, not a detector result:

1. **Verification and Discussion:** several paragraphs repeated the distinction between a software check and an integrated hardware trial. The revisions connect each limitation to the particular evidence or failure path it affects.
2. **Related Work, Introduction and Conclusion:** the opening comparison repeated prior systems and the paper's status. The revision organizes the comparison around where location and communication functions reside and restates the contribution in terms of the available evidence.
3. **Abstract, System Architecture and Wearable Design:** these sections already contained substantial project detail. Selected passages were revised to explain the SOS and location paths, the phone dependency and documented electrical choices more directly. Information-dense component and peripheral descriptions were retained where another rewrite would not improve them.

## Section-by-section changes

The percentages estimate the proportion of original prose sentences without an exact match in the corresponding revised section. Whitespace is normalized, and headings, figures, tables, captions, bibliography and author comments are excluded. Splitting or merging sentences affects these approximate figures. They are not similarity or AI-detection scores.

| Section | Approximate sentences changed | Change |
| --- | ---: | --- |
| Abstract | 89% | Reorganized the system, available checks and unimplemented functions into a direct account of the prototype. |
| Introduction | 91% | Explained the alert path and separated the functioning app from the wearable design. |
| Related Work | 69% | Compared on-device and phone-assisted communication, sensing and evidence boundaries. |
| System Architecture | 38% | Clarified when the client uses remote services, how a location fix affects the SOS request and how delivery attempts reach guardians. |
| Wearable Design | 30% | Emphasized the modeled charging window, current-based runtime assumptions and documented capacitor-selection trade-off. |
| Verification Method and Evidence | 75% | Connected each software, CAD and firmware check to the question it can answer and added examples of ignored ERC diagnostics from the project register. |
| Discussion and Limitations | 90% | Reorganized integration, notification, privacy and participant-related limitations around the actual alert path. |
| Conclusion | 67% | Restated the present evidence and next integration steps. |

The reason for replacing the input capacitor is supported by the [project power budget](../../smart-safety-tag-v1/docs/power-budget.md). The named ignored ERC diagnostic examples are supported by the [verification register](../../smart-safety-tag-v1/docs/verification.md). No new experimental results, measurements or references were added.

## Author input requested

The manuscript contains matching TODO(author) comments at the relevant passages:

1. Explain the team's reasons for choosing the phone-assisted alert path and any additional design constraints.
2. Check whether the broad statement about location and alert data revealing routines needs a separate citation.
3. Explain the practical reasons for a separate charging adapter, if documented.
4. Confirm the manufacturer evidence for the capacitor selection and whether it needs a direct citation.
5. Identify any documented software-testing failures or unexpected outcomes suitable for discussion.
6. Confirm whether physical integration or alert-path trials have taken place since the saved records.
7. Describe the intended participant group and consent procedure when a study protocol exists.
8. Explain any project constraints that prevented fabrication or physical validation, if appropriate for publication.

These comments request information; they are not claims of completed work. Affiliations and corresponding-author details also remain to be confirmed. The requested citation restrictions were observed, so the source questions above remain unresolved for author review.

## Verification

- pdfLaTeX, BibTeX and two further pdfLaTeX runs completed. The revised PDF has 10 pages, compared with 10 before this pass; its first page and verification and discussion pages were visually reviewed.
- The final build reports no overfull boxes, unresolved references or citation warnings. All five figures, three tables and 21 bibliography entries remain present.
- The 27 citation commands, 8 reference commands, 8 labels, 9 inline-math expressions, document preamble, all figure and table environments, bibliography and figure assets were checked against the preceding draft. Numeric literals were compared by section, and their associated statements were reviewed.
- The portable source archive contains the revised main.tex. No application code was changed; the software-test results described in the paper remain the previously recorded results.
- The supplied report's 83% is an AI-writing estimate for an earlier draft, not a text-similarity score. The detector was not run on this revision. The authors must rerun it themselves; no revised percentage or threshold is claimed.
