balu-16/SeedGrant_Safety/journal/ieee/figures/adapter_board.pdf

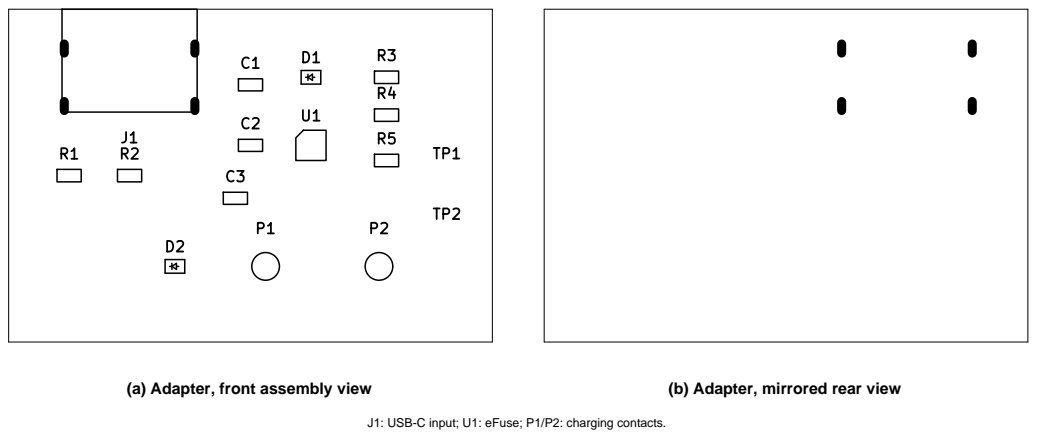
[picture p22: page 1]

J1: USB-C input; U1: eFuse; P1/P2: charging contacts.
