balu-16/SeedGrant_Safety/smart-safety-tag-v1/manufacturing/charging-adapter/assembly/charging-adapter-schematic.pdf

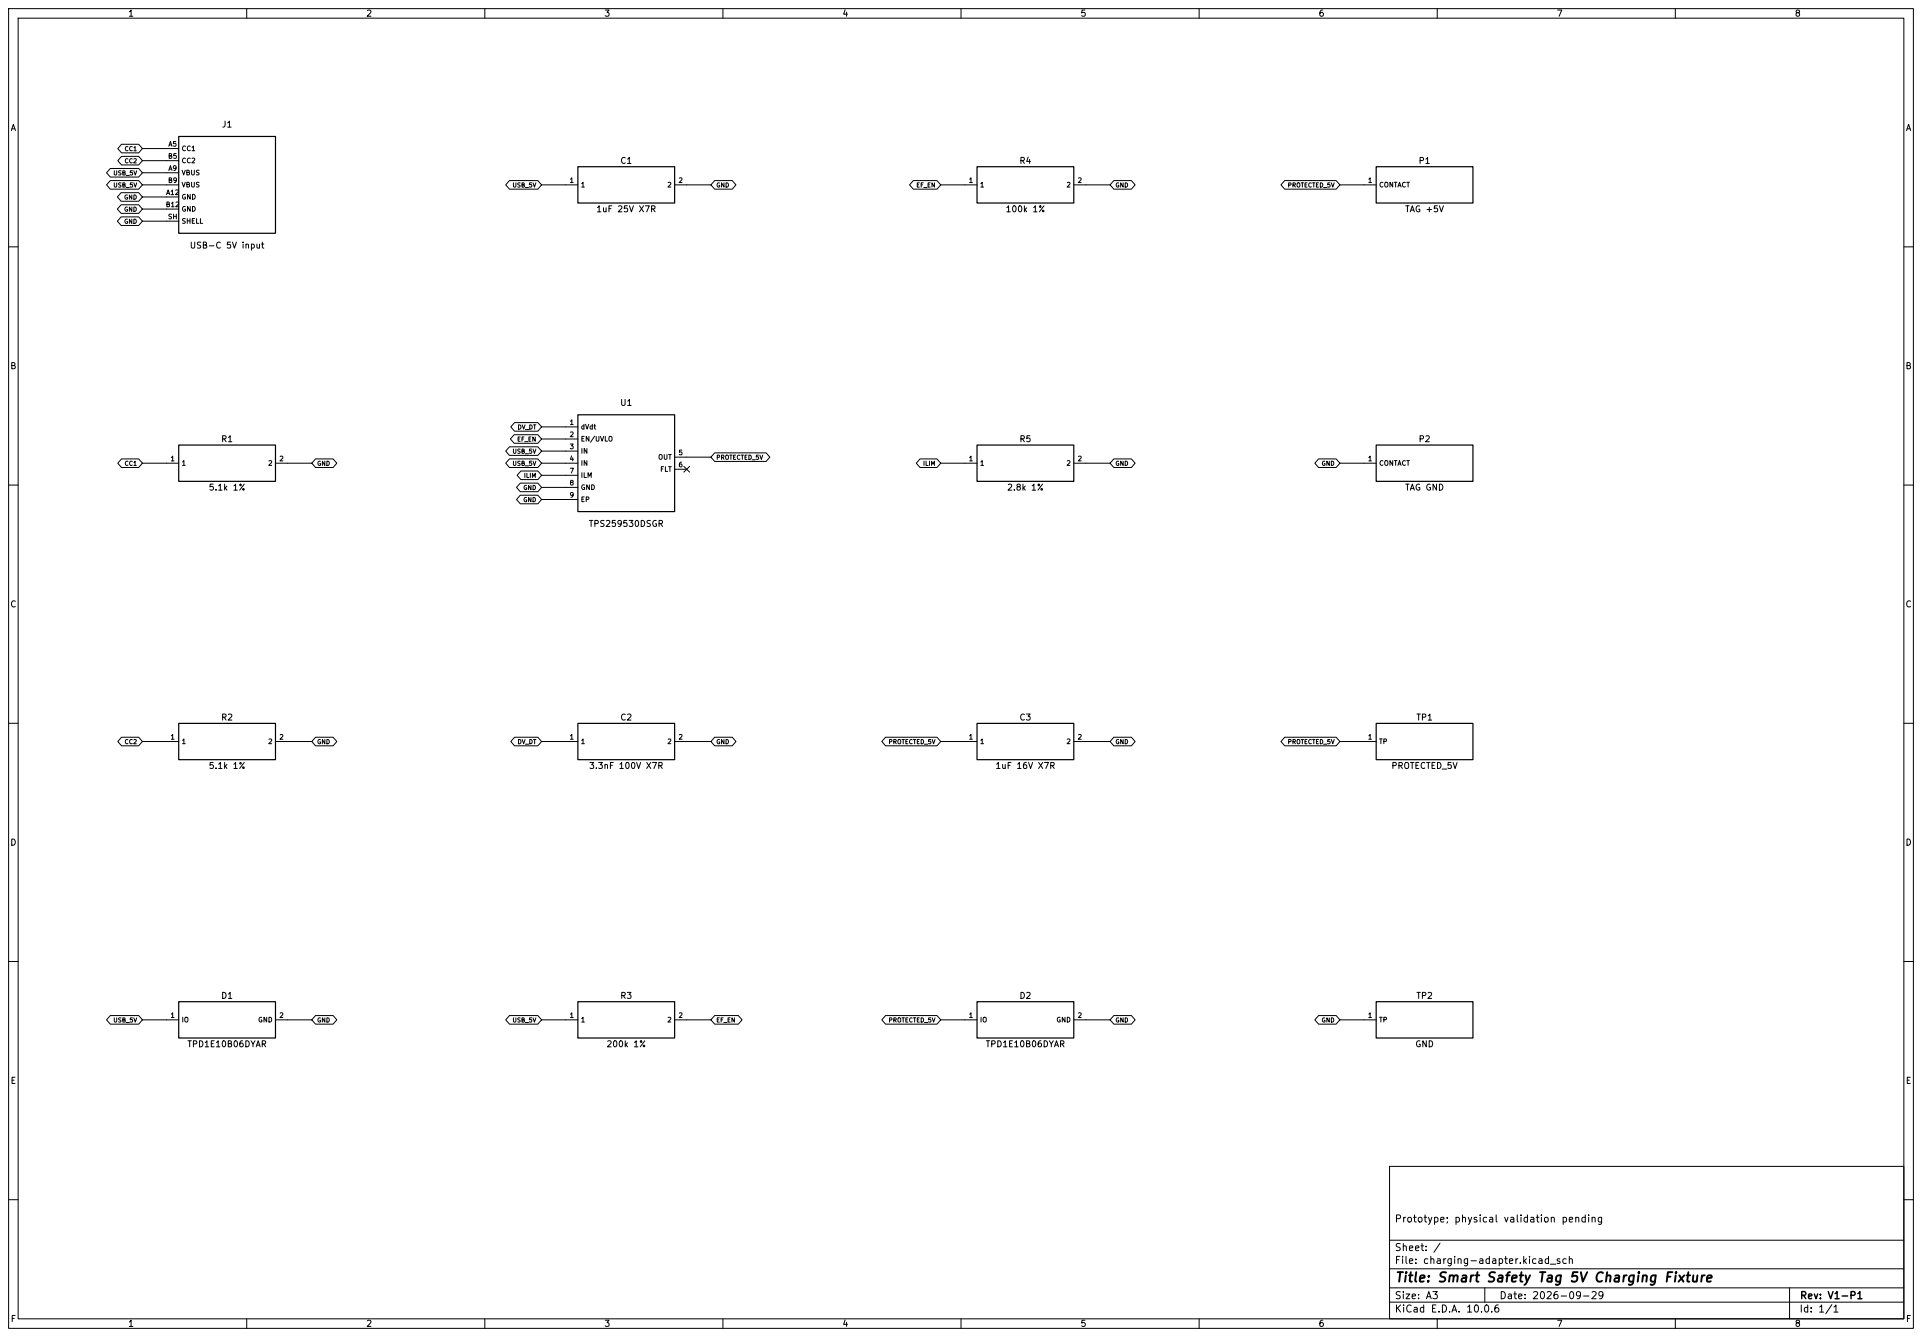
[picture p23: page 1]

Prototype; physical validation pending

Sheet: /
File: charging-adapter.kicad_sch
Title: Smart Safety Tag 5V Charging Fixture

Size: A3 | Rev: V1-P1 | F Date: 2026-09-29
KiCad E.D.A. 10.0.6 | Id: 1/1
