balu-16/SeedGrant_Safety/smart-safety-tag-v1/manufacturing/tag/assembly/smart-safety-tag-schematic.pdf

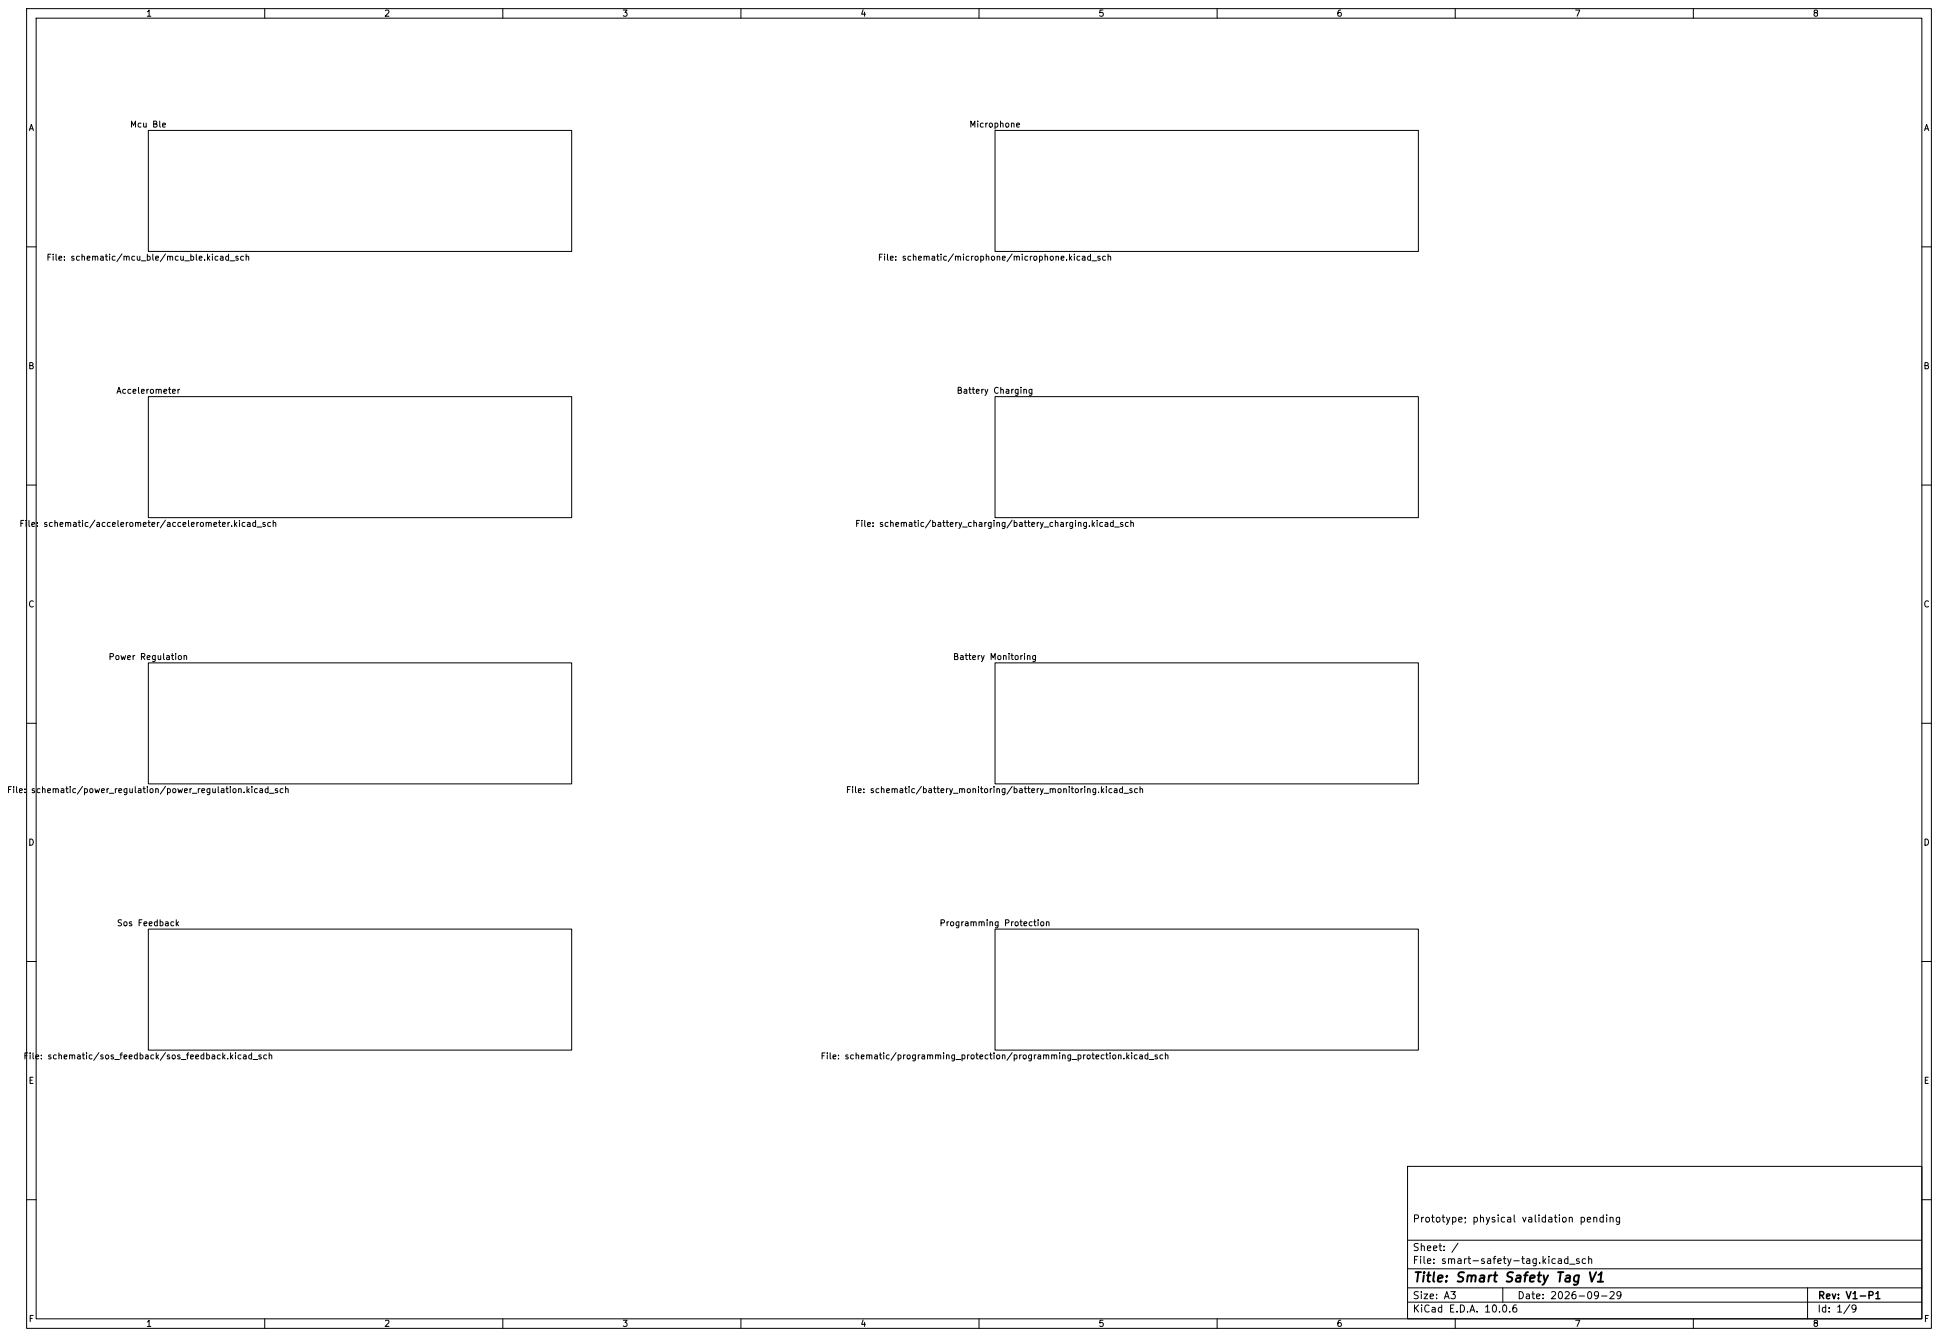
[picture p24: page 1]

File: schematic/microphone/microphone.kicad_sch

Accelerometer File: schematic/accelerometer/accelerometer.kicad_sch

File: schematic/battery_charging/battery_charging.kicad_sch Power Regulation

File: schematic/battery_monitoring/battery_monitoring.kicad_sch Sos Feedback File: schematic/sos_feedback/sos_feedback.kicad_sch

Prototype; physical validation pending

Sheet: /
File: smart-safety-tag.kicad_sch
Title: Smart Safety Tag V1

Size: A3 | Rev: V1-P1 | F Date: 2026-09-29
KiCad E.D.A. 10.0.6 | Id: 1/9

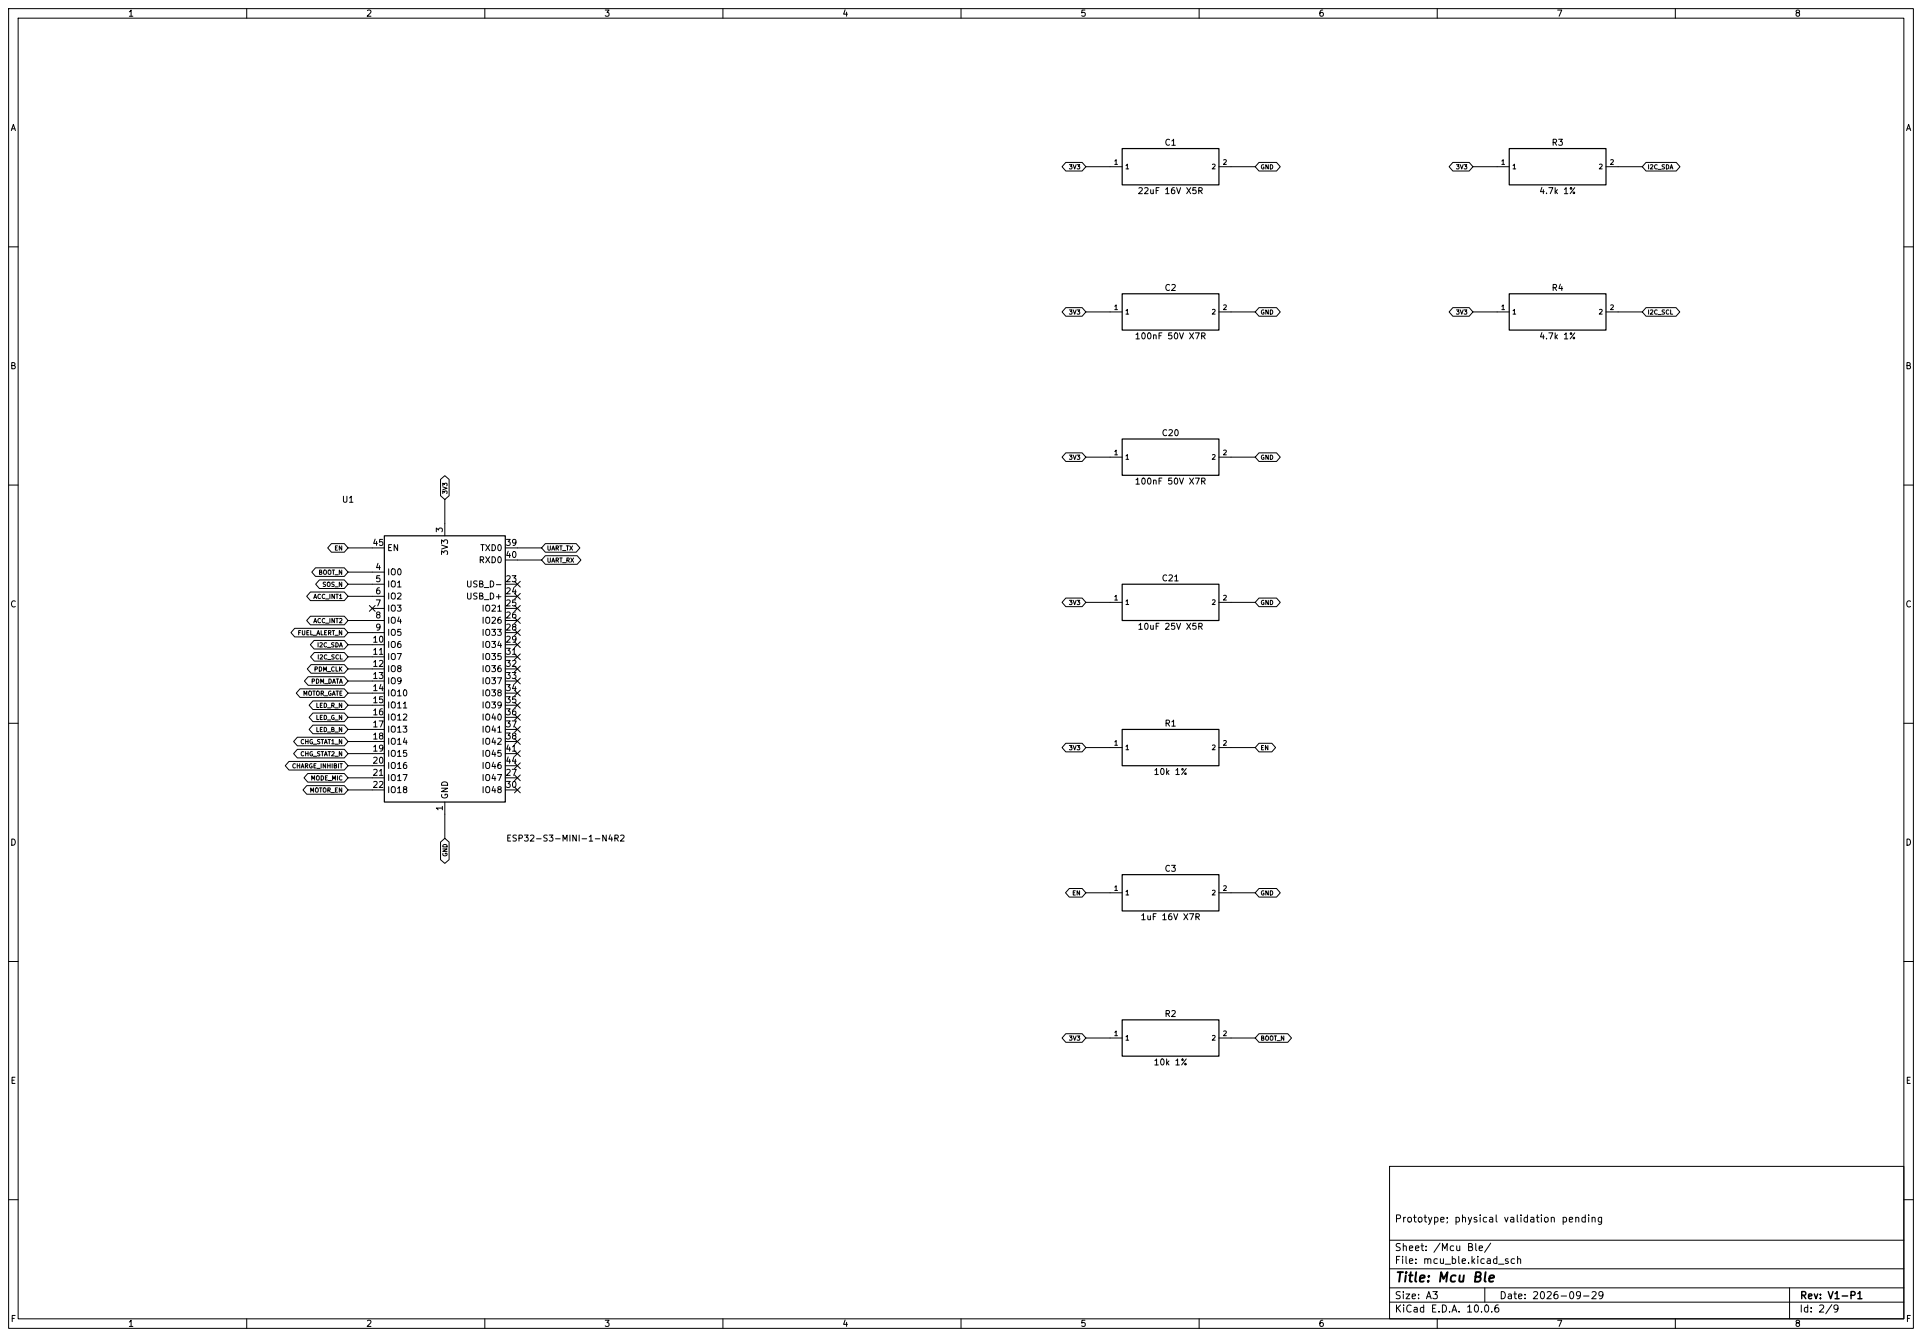
[picture p25: page 2]

1 | 2 | 3 | 4 | 5 | 6 | 7 | 8 1 | 2 | 3 | 4 | 5 | 6 | 7 | 8 ABCDEF | ABCDEF Date: 2026-09-29

# Title: Microphone

## File: microphone.kicad_sch

## Sheet: /Microphone/

Prototype; physical validation pending 1 1 | 2 | 2 C6
1uF 16V X7R 1 1 | 2 | 2 C27
1uF 16V X7R 1 1 | 2 | 2 C26
1uF 16V X7R 1 1 | 2 | 2 C22
1uF 16V X7R 1 1 | 2 | 2 R6
10k 1% 1 1 | 2 | 2 R5
1k 1% 1 1 | 2 | 2 C5

1uF 16V X7R

DATA | 1
LR 2 | GND 3 | CLOCK 4
VDD 5 | U2
IM67D128BV01 1 1 | 2 | 2 C4

1uF 16V X7R

IN 1 | GND 2
EN 3 | NC 4 | OUT | 5 U3

TPS7A2030PDBVR
MIC_3V0 | GND MIC_3V0 MIC_3V0 PDM_CLK_3V0 | GND

PDM_CLK_3V0

# MIC_3V0 MIC_3V0

# 3V3 PDM_CLK

GND

GND

PDM_CLK_3V0 GND

GND

GND

GND

3V3 GND MODE_MIC

# PDM_DATA MIC_3V0

3V3 | GND

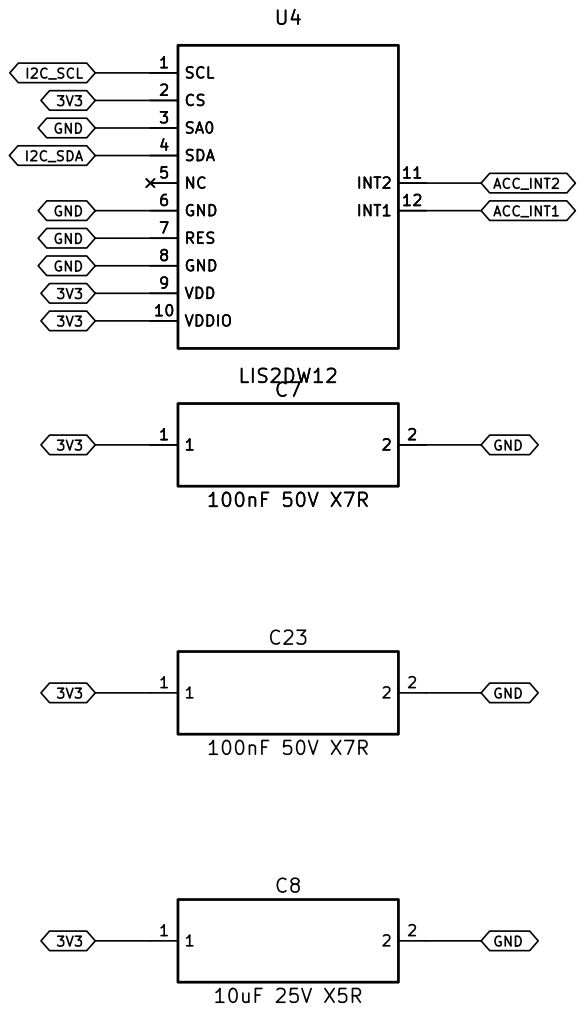
[picture p26: page 4]

Prototype; physical validation pending

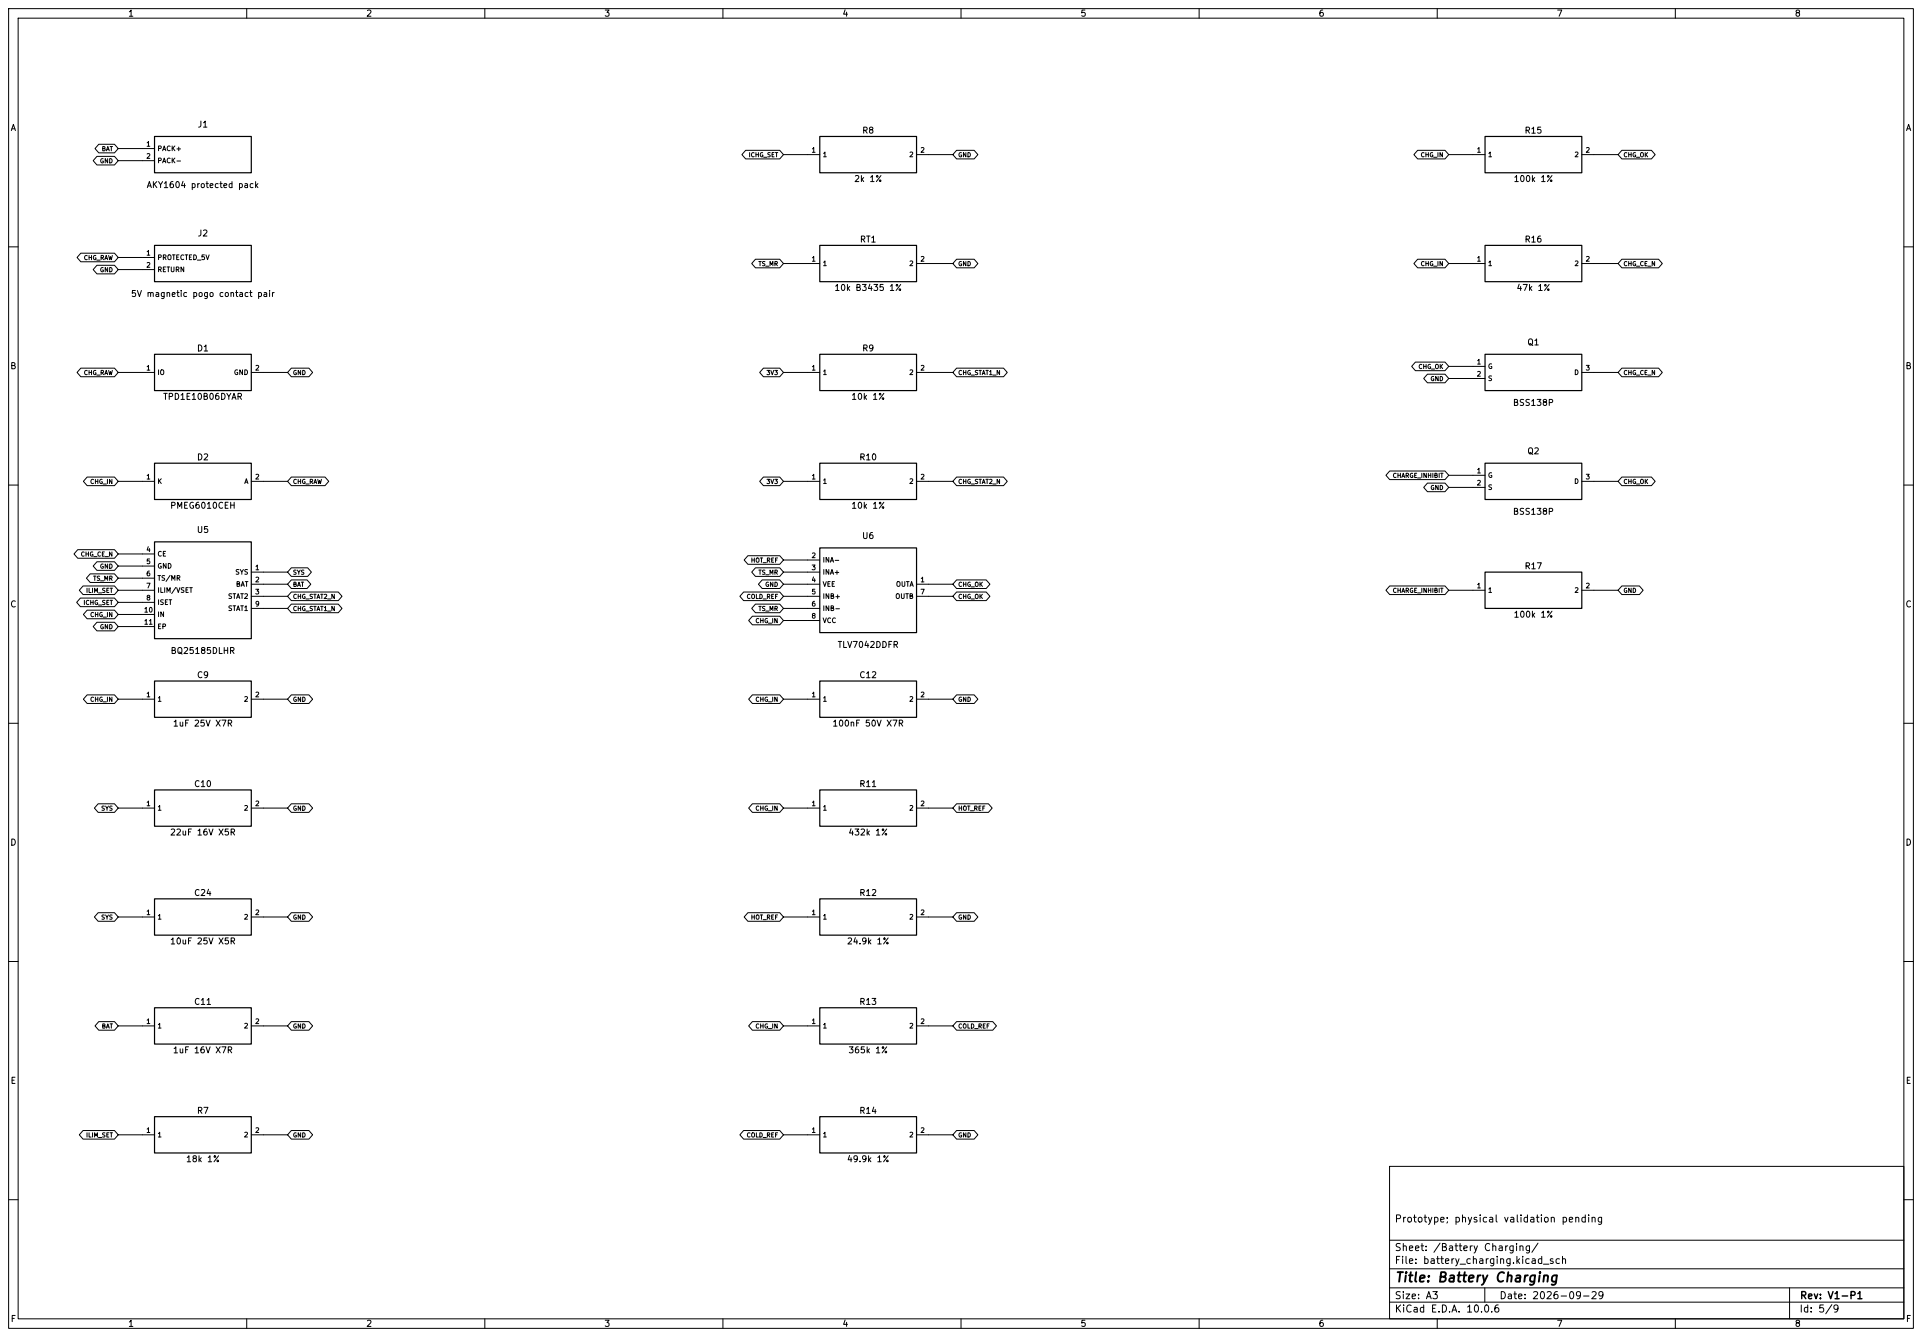
[picture p27: page 5]

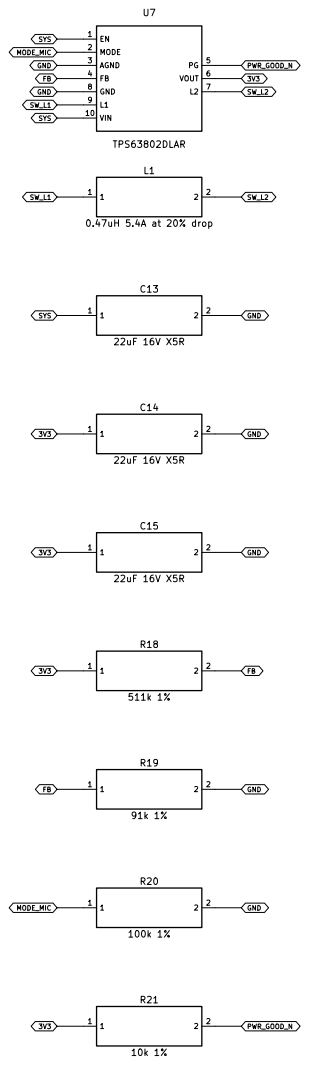
[picture p28: page 6]

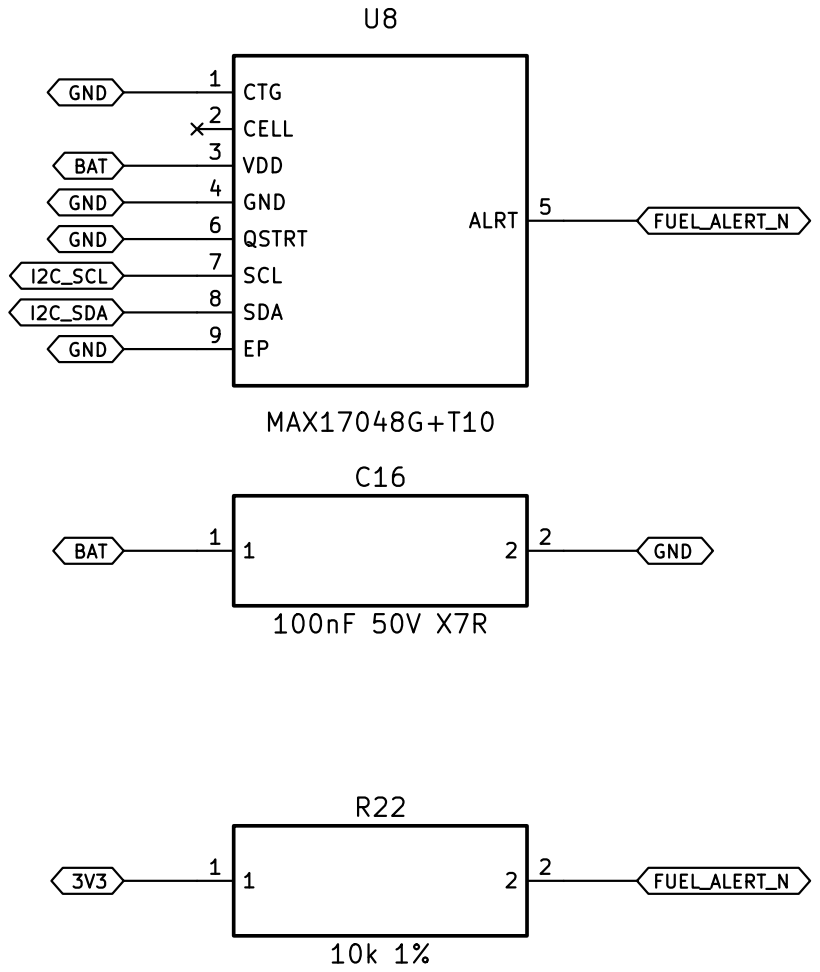
[picture p29: page 7]

Prototype; physical validation pending

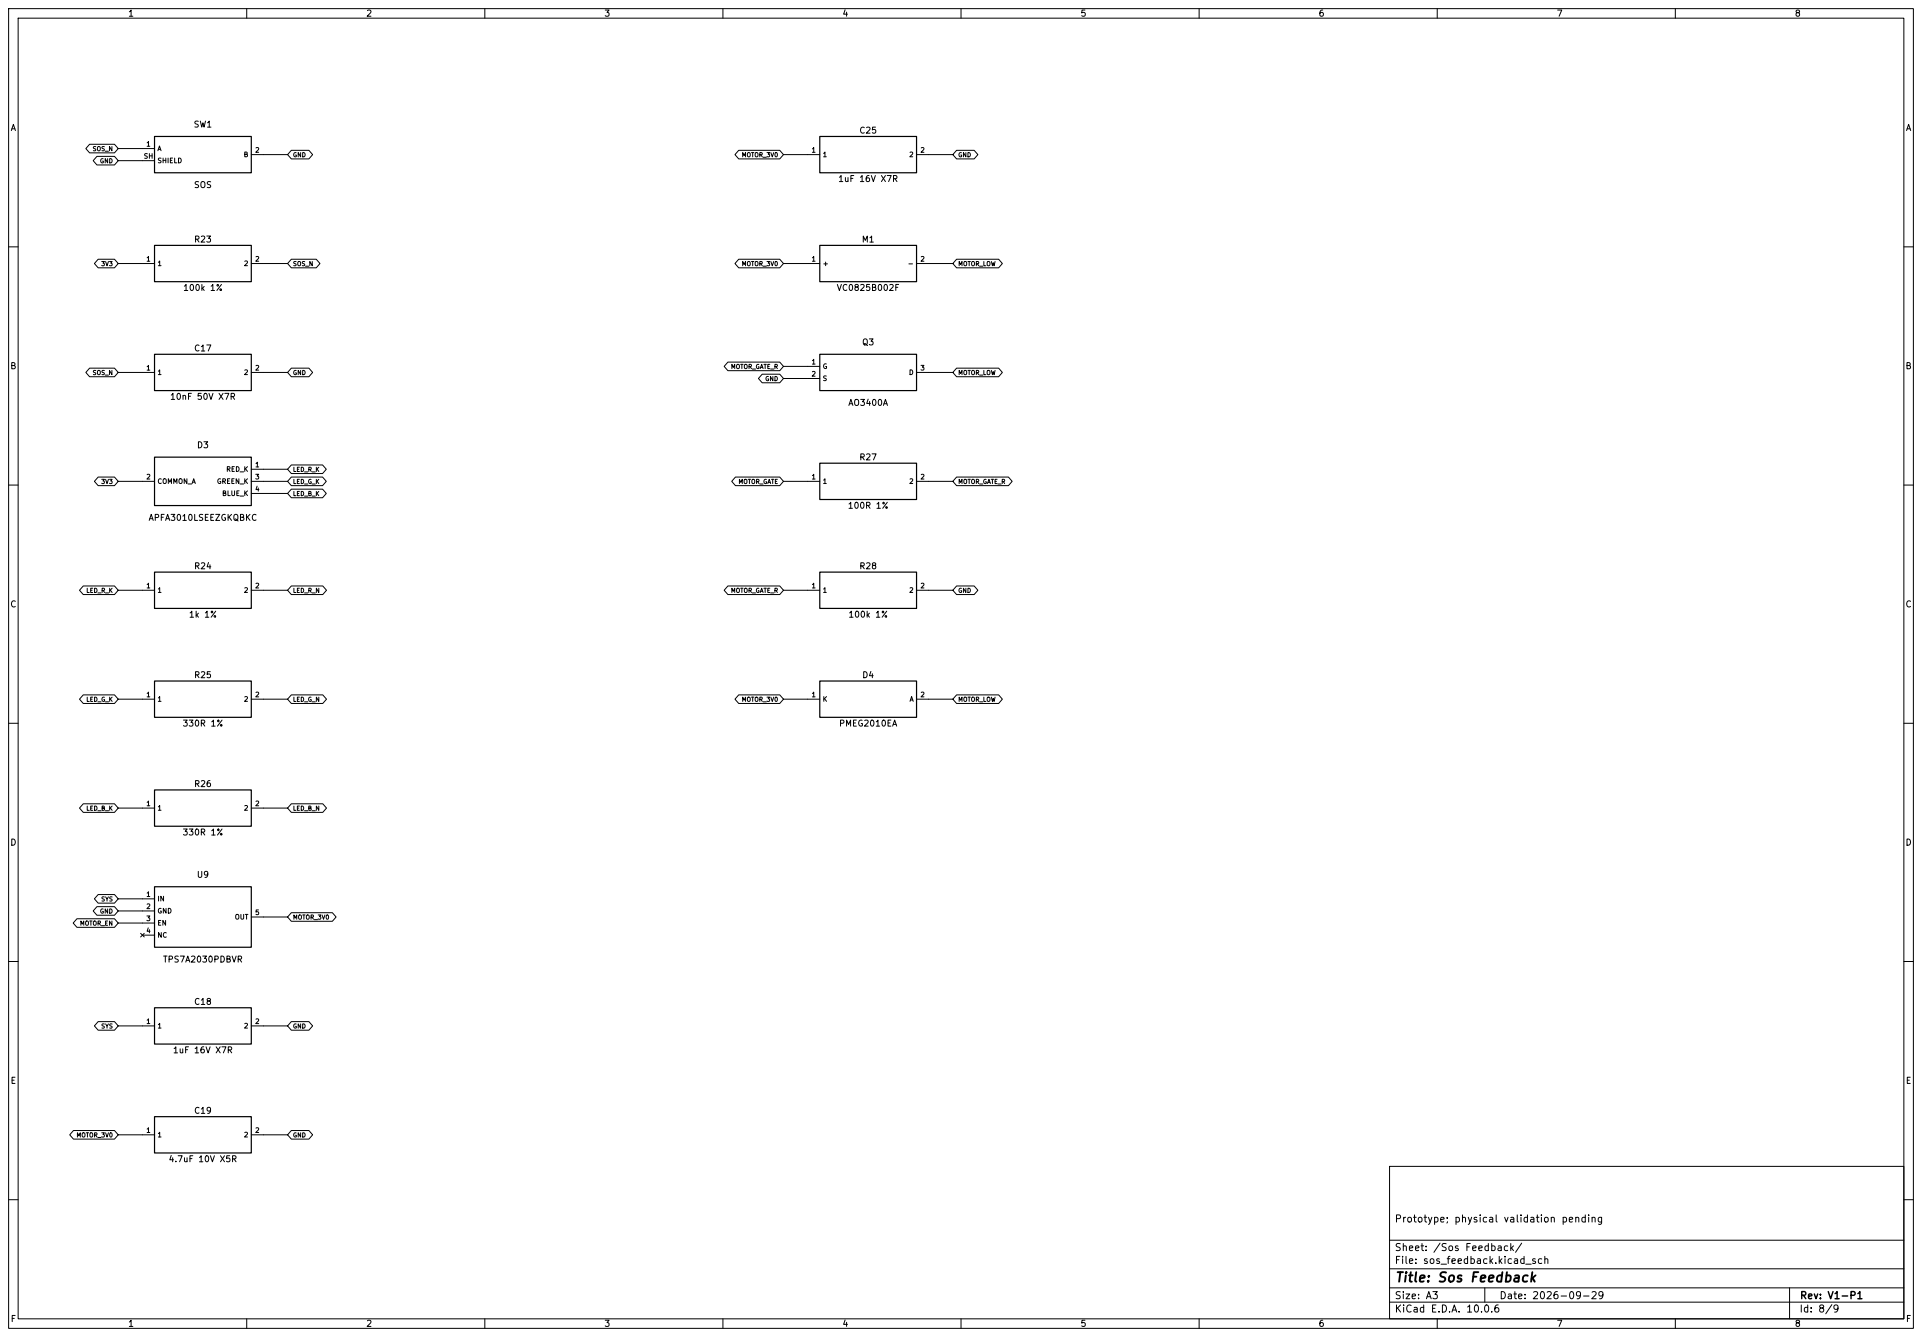
[picture p30: page 8]

Prototype; physical validation pending

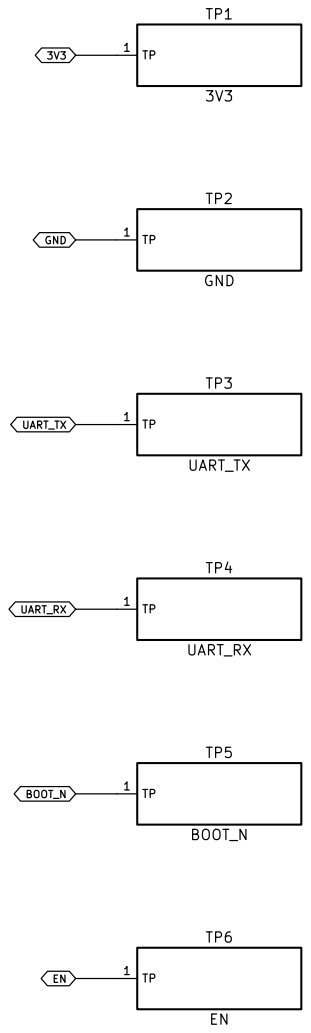
[picture p31: page 9]

Prototype; physical validation pending
