balu-16/SeedGrant_Safety/smart-safety-tag-v1/manufacturing/charging-adapter/assembly/charging-adapter-front-assembly.pdf

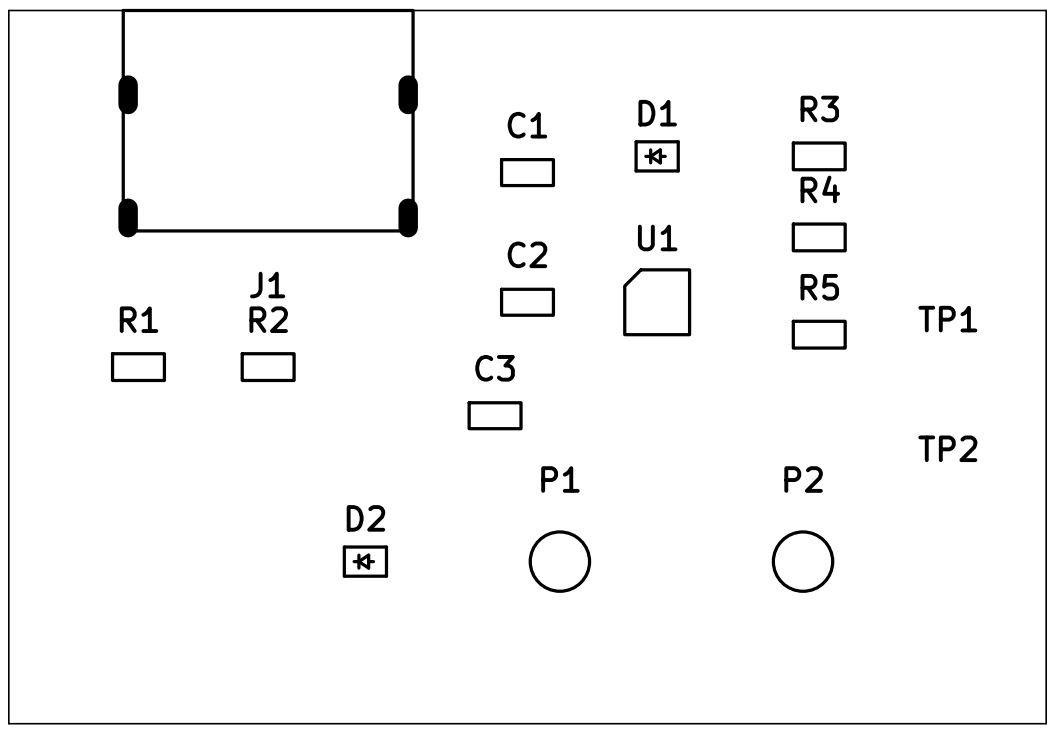
[picture p32: page 1]
