balu-16/SeedGrant_Safety/smart-safety-tag-v1/manufacturing/tag/assembly/smart-safety-tag-back-assembly.pdf

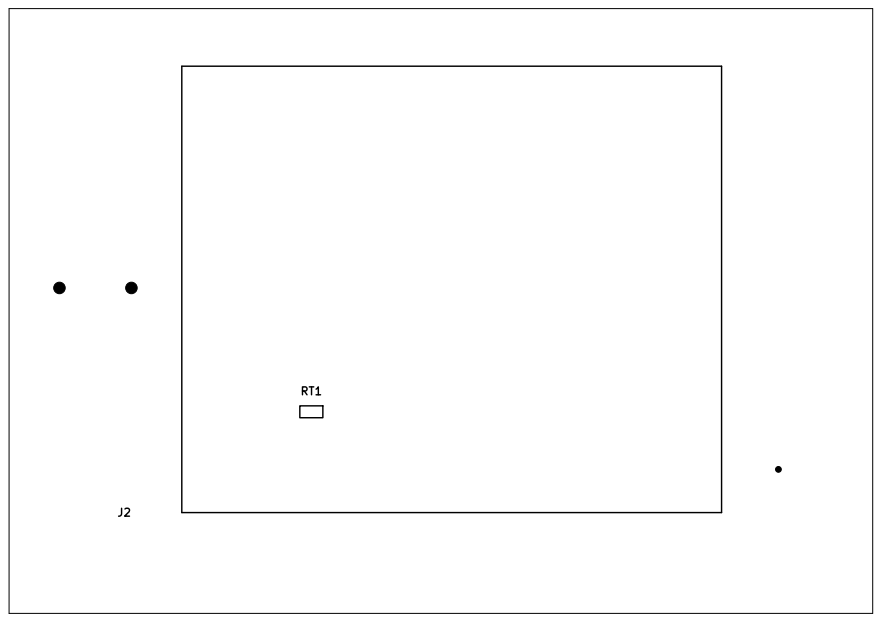
[picture p33: page 1]
