balu-16/SeedGrant_Safety/smart-safety-tag-v1/manufacturing/tag/assembly/smart-safety-tag-front-assembly.pdf

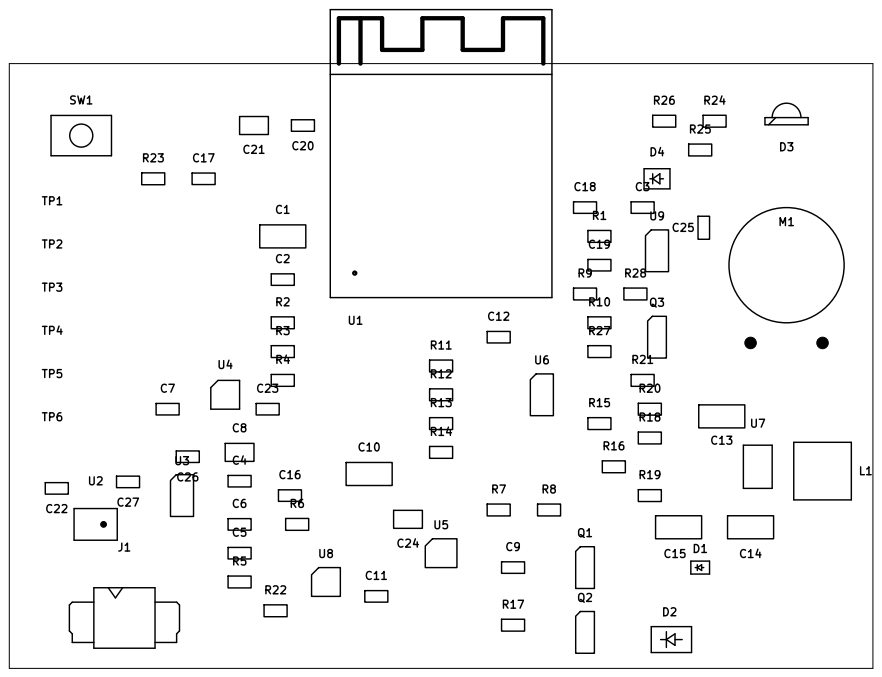
[picture p34: page 1]
