balu-16/SeedGrant_Safety/smart-safety-tag-v1/hardware/tag/smart-safety-tag.kicad_pcb

## KiCad design smart-safety-tag-v1/hardware/tag/smart-safety-tag.kicad_pcb (2026-09-29)

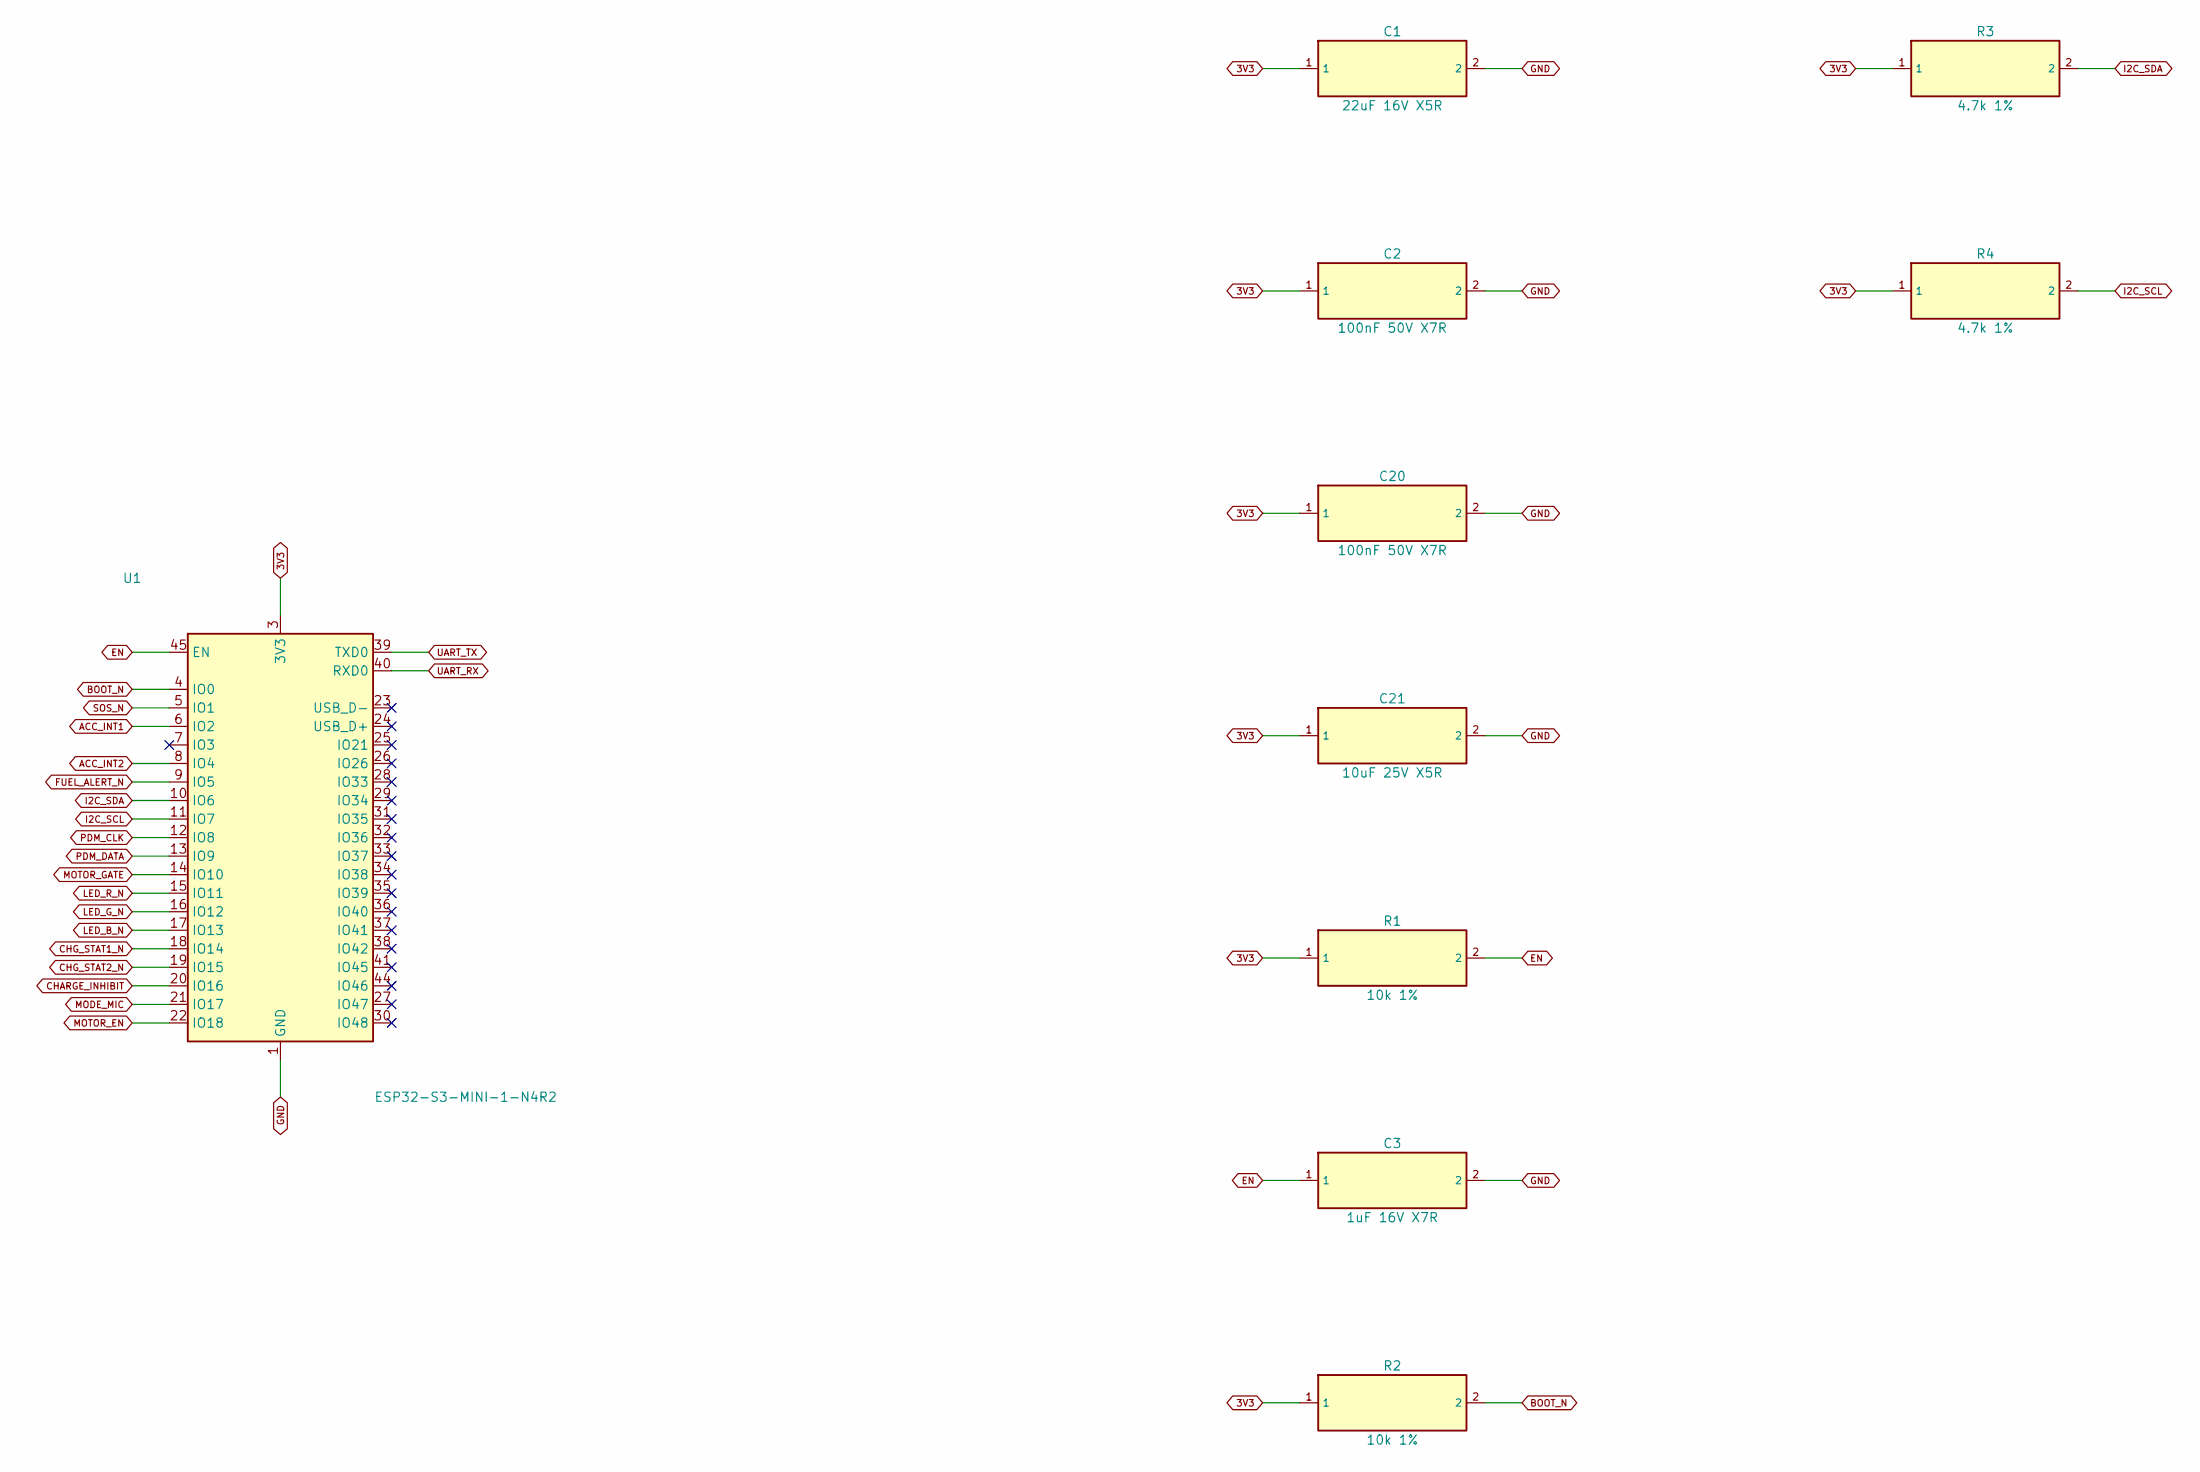
[picture p35: schematic mcu_ble.kicad_sch, Mcu Ble]

Parts:
C1: 22uF 16V X5R; C_1206_3216Metric; MPN C3216X5R1C226M160AB
C2, C20: 100nF 50V X7R; C_0603_1608Metric; MPN C1608X7R1H104K080AA
C3: 1uF 16V X7R; C_0603_1608Metric; MPN C1608X7R1C105K080AC
C21: 10uF 25V X5R; C_0805_2012Metric; MPN C2012X5R1E106K125AB
R1, R2: 10k 1%; R_0603_1608Metric; MPN RC0603FR-0710KL
R3, R4: 4.7k 1%; R_0603_1608Metric; MPN RC0603FR-074K7L
U1: ESP32-S3-MINI-1-N4R2; ESP32-S2-MINI-1; MPN ESP32-S3-MINI-1-N4R2

Connections:
3V3: C1.1, C2.1, C20.1, C21.1, R1.1, R2.1, R3.1, R4.1, U1.3 (3V3); also elsewhere on the board
ACC_INT1: U1.6 (IO2); also elsewhere on the board
ACC_INT2: U1.8 (IO4); also elsewhere on the board
BOOT_N: R2.2, U1.4 (IO0); also elsewhere on the board
CHARGE_INHIBIT: U1.20 (IO16); also elsewhere on the board
CHG_STAT1_N: U1.18 (IO14); also elsewhere on the board
CHG_STAT2_N: U1.19 (IO15); also elsewhere on the board
EN: C3.1, R1.2, U1.45 (EN); also elsewhere on the board
FUEL_ALERT_N: U1.9 (IO5); also elsewhere on the board
GND: C1.2, C2.2, C3.2, C20.2, C21.2, U1.1 (GND), U1.2 (GND), U1.42 (GND), U1.43 (GND), U1.46 (GND), U1.47 (GND), U1.48 (GND), U1.49 (GND), U1.50 (GND), U1.51 (GND), U1.52 (GND), U1.53 (GND), U1.54 (GND), U1.55 (GND), U1.56 (GND), U1.57 (GND), U1.58 (GND), U1.59 (GND), U1.60 (GND), U1.61 (GND), U1.62 (GND), U1.63 (GND), U1.64 (GND), U1.65 (GND); also elsewhere on the board
I2C_SCL: R4.2, U1.11 (IO7); also elsewhere on the board
I2C_SDA: R3.2, U1.10 (IO6); also elsewhere on the board
LED_B_N: U1.17 (IO13); also elsewhere on the board
LED_G_N: U1.16 (IO12); also elsewhere on the board
LED_R_N: U1.15 (IO11); also elsewhere on the board
MODE_MIC: U1.21 (IO17); also elsewhere on the board
MOTOR_EN: U1.22 (IO18); also elsewhere on the board
MOTOR_GATE: U1.14 (IO10); also elsewhere on the board
PDM_CLK: U1.12 (IO8); also elsewhere on the board
PDM_DATA: U1.13 (IO9); also elsewhere on the board
SOS_N: U1.5 (IO1); also elsewhere on the board
UART_RX: U1.40 (RXD0); also elsewhere on the board
UART_TX: U1.39 (TXD0); also elsewhere on the board

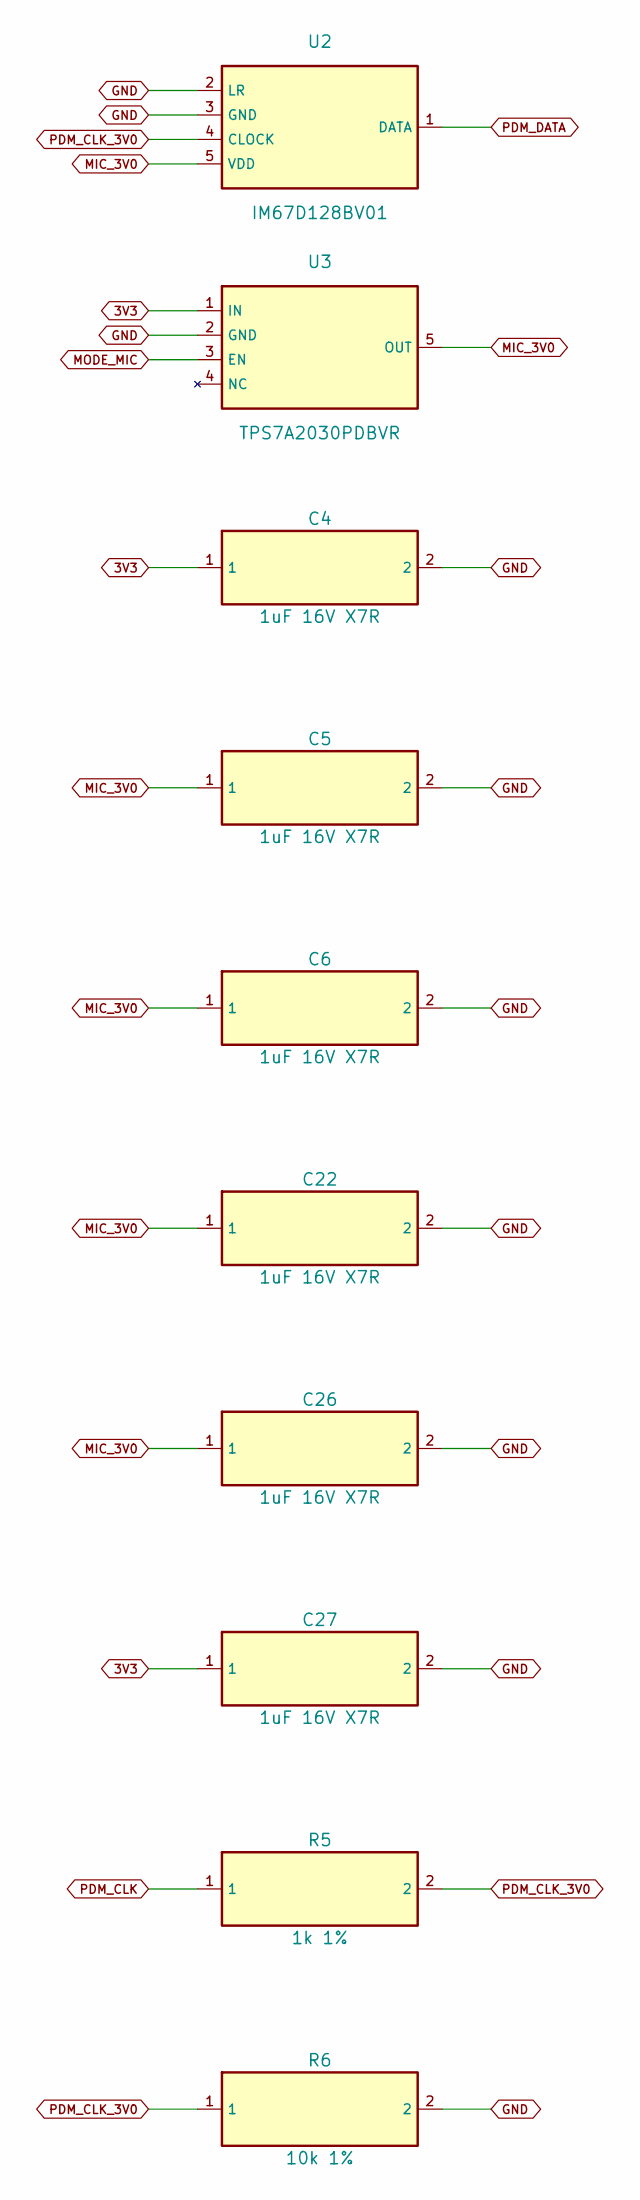
[picture p36: schematic microphone.kicad_sch]

Parts:
C4, C5, C6, C22, C26, C27: 1uF 16V X7R; C_0603_1608Metric; MPN C1608X7R1C105K080AC
R5: 1k 1%; R_0603_1608Metric; MPN RC0603FR-071KL
R6: 10k 1%; R_0603_1608Metric; MPN RC0603FR-0710KL
U2: IM67D128BV01; Infineon_IM67D128BV01; MPN IM67D128BV01
U3: TPS7A2030PDBVR; SOT-23-5; MPN TPS7A2030PDBVR

Connections:
3V3: C4.1, C27.1, U3.1 (IN); also elsewhere on the board
GND: C4.2, C5.2, C6.2, C22.2, C26.2, C27.2, R6.2, U2.2 (LR), U2.3 (GND), U3.2 (GND); also elsewhere on the board
MIC_3V0: C5.1, C6.1, C22.1, C26.1, U2.5 (VDD), U3.5 (OUT)
MODE_MIC: U3.3 (EN); also elsewhere on the board
PDM_CLK: R5.1; also elsewhere on the board
PDM_CLK_3V0: R5.2, R6.1, U2.4 (CLOCK)
PDM_DATA: U2.1 (DATA); also elsewhere on the board

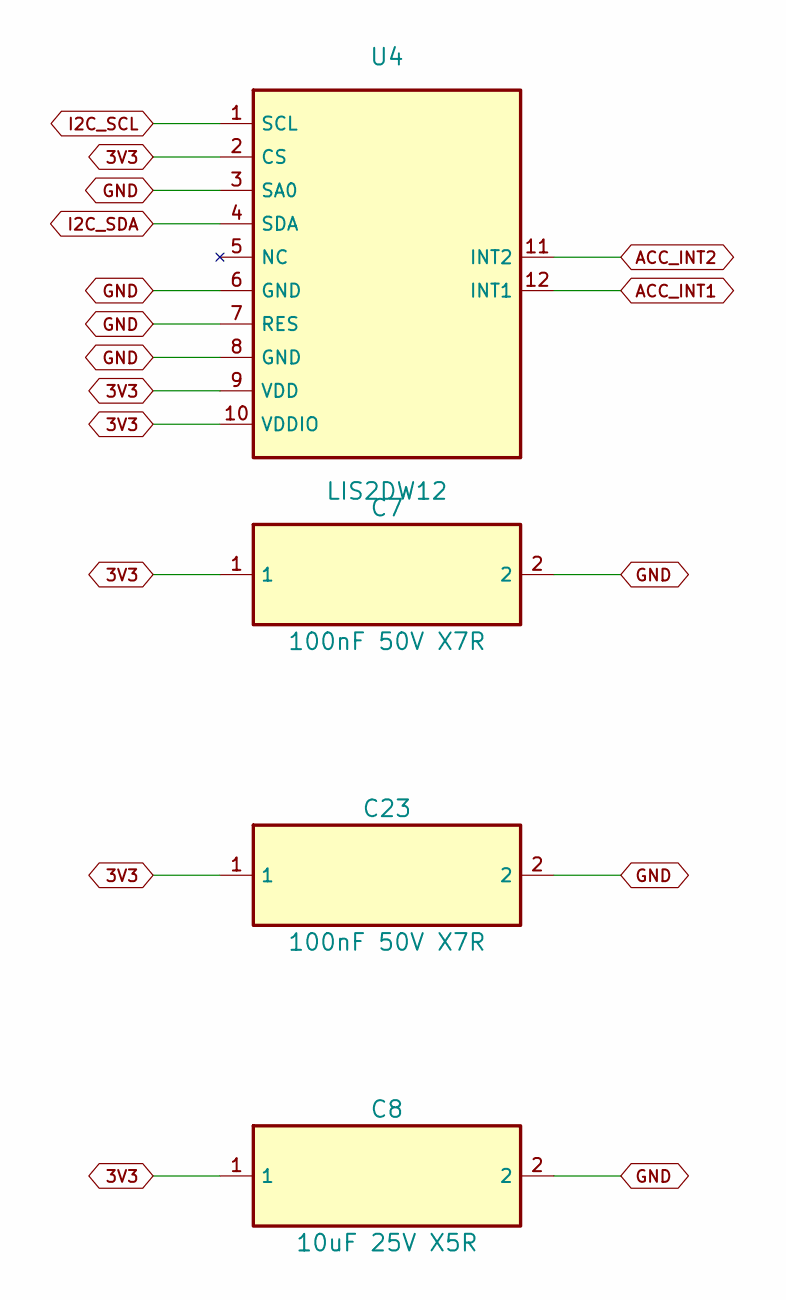
[picture p37: schematic accelerometer.kicad_sch]

Parts:
C7, C23: 100nF 50V X7R; C_0603_1608Metric; MPN C1608X7R1H104K080AA
C8: 10uF 25V X5R; C_0805_2012Metric; MPN C2012X5R1E106K125AB
U4: LIS2DW12; LGA-12_2x2mm_P0.5mm; MPN LIS2DW12TR

Connections:
3V3: C7.1, C8.1, C23.1, U4.2 (CS), U4.9 (VDD), U4.10 (VDDIO); also elsewhere on the board
ACC_INT1: U4.12 (INT1); also elsewhere on the board
ACC_INT2: U4.11 (INT2); also elsewhere on the board
GND: C7.2, C8.2, C23.2, U4.3 (SA0), U4.6 (GND), U4.7 (RES), U4.8 (GND); also elsewhere on the board
I2C_SCL: U4.1 (SCL); also elsewhere on the board
I2C_SDA: U4.4 (SDA); also elsewhere on the board

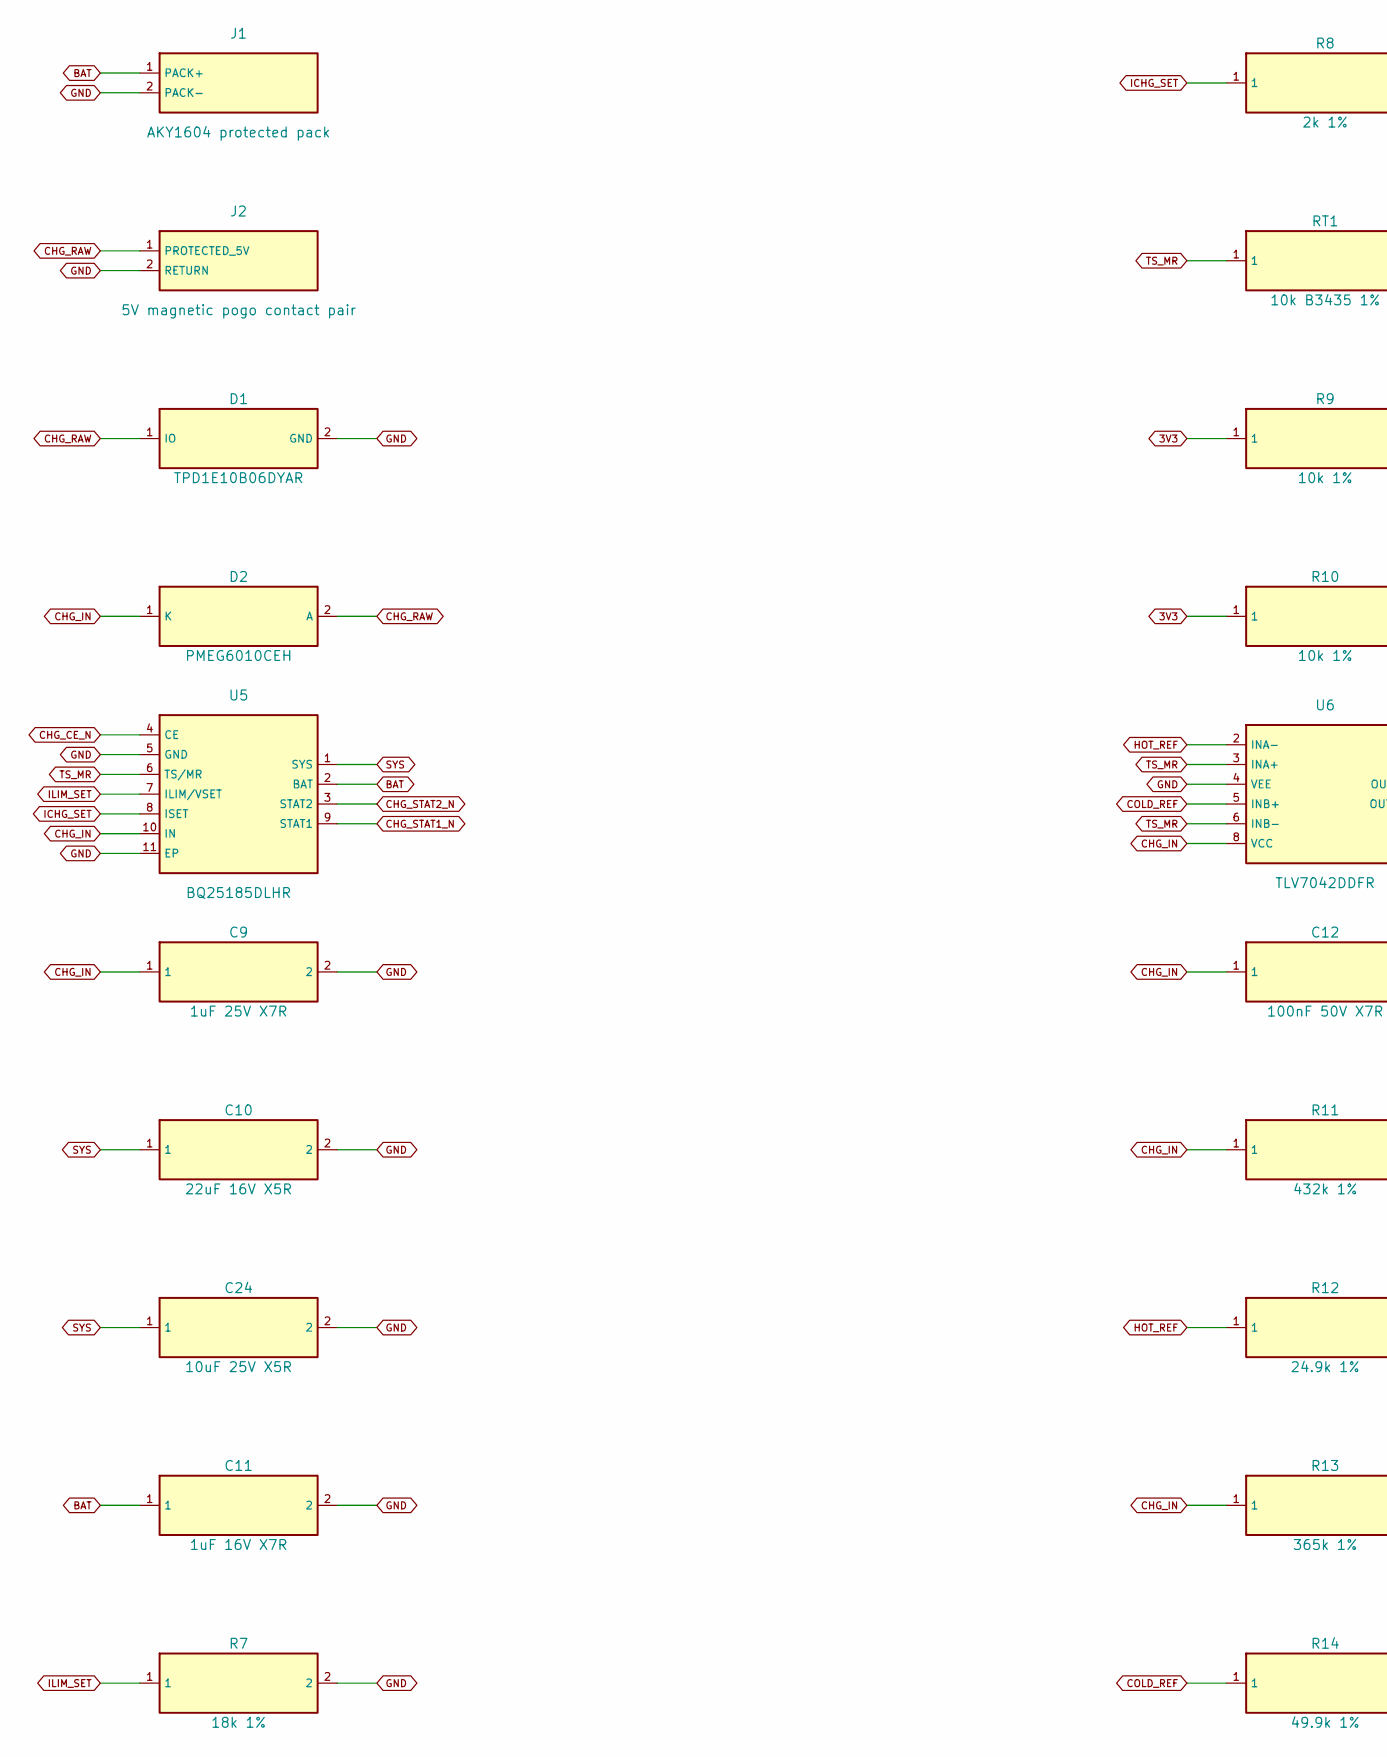
[picture p38: schematic battery_charging.kicad_sch, Battery Charging, part in row 1, column 1]

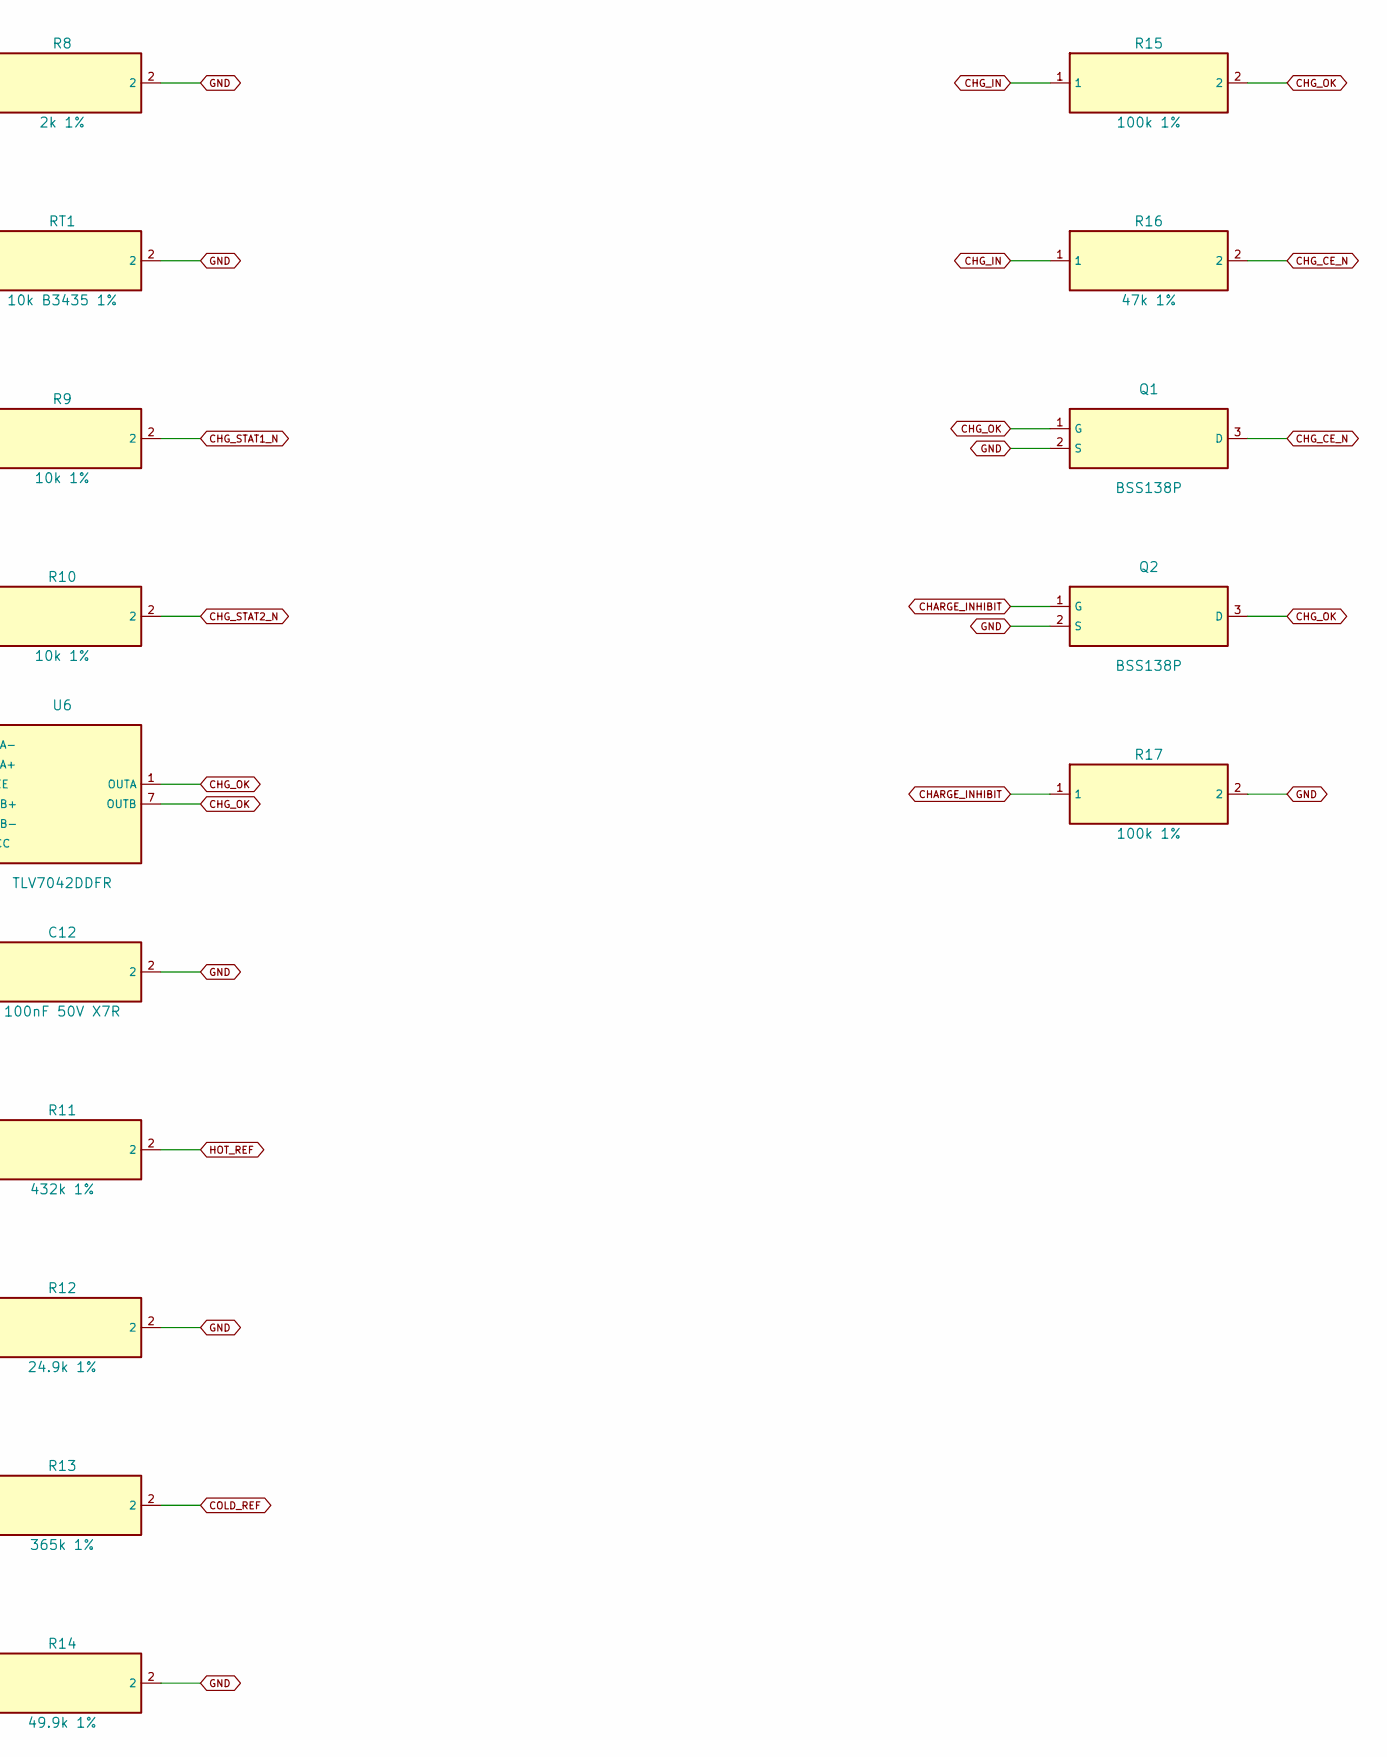
[picture p39: schematic battery_charging.kicad_sch, Battery Charging, part in row 1, column 2]

Parts:
C9: 1uF 25V X7R; C_0603_1608Metric; MPN C1608X7R1E105K080AE
C10: 22uF 16V X5R; C_1206_3216Metric; MPN C3216X5R1C226M160AB
C11: 1uF 16V X7R; C_0603_1608Metric; MPN C1608X7R1C105K080AC
C12: 100nF 50V X7R; C_0603_1608Metric; MPN C1608X7R1H104K080AA
C24: 10uF 25V X5R; C_0805_2012Metric; MPN C2012X5R1E106K125AB
D1: TPD1E10B06DYAR; D_SOD-523; MPN TPD1E10B06DYAR
D2: PMEG6010CEH; D_SOD-123F; MPN PMEG6010CEH,115
J1: AKY1604 protected pack; Molex_PicoBlade_53261-0271_1x02-1MP_P1.25mm_Horizontal; MPN 53261-0271
J2: 5V magnetic pogo contact pair; Pogo_Charge_2Pin
Q1, Q2: BSS138P; SOT-23; MPN BSS138P,215
R7: 18k 1%; R_0603_1608Metric; MPN RC0603FR-0718KL
R8: 2k 1%; R_0603_1608Metric; MPN RC0603FR-072KL
R9, R10: 10k 1%; R_0603_1608Metric; MPN RC0603FR-0710KL
R11: 432k 1%; R_0603_1608Metric; MPN RC0603FR-07432KL
R12: 24.9k 1%; R_0603_1608Metric; MPN RC0603FR-0724K9L
R13: 365k 1%; R_0603_1608Metric; MPN RC0603FR-07365KL
R14: 49.9k 1%; R_0603_1608Metric; MPN RC0603FR-0749K9L
R15, R17: 100k 1%; R_0603_1608Metric; MPN RC0603FR-07100KL
R16: 47k 1%; R_0603_1608Metric; MPN RC0603FR-0747KL
RT1: 10k B3435 1%; R_0603_1608Metric; MPN B57332V5103A260
U5: BQ25185DLHR; Texas_DLH0010A_WSON-10-1EP_2.2x2mm_P0.4mm_EP0.9x1.5mm; MPN BQ25185DLHR
U6: TLV7042DDFR; SOT-23-8; MPN TLV7042DDFR

Connections:
3V3: R9.1, R10.1; also elsewhere on the board
BAT: C11.1, J1.1 (PACK+), U5.2 (BAT); also elsewhere on the board
CHARGE_INHIBIT: Q2.1 (G), R17.1; also elsewhere on the board
CHG_CE_N: Q1.3 (D), R16.2, U5.4 (CE)
CHG_IN: C9.1, C12.1, D2.1 (K), R11.1, R13.1, R15.1, R16.1, U5.10 (IN), U6.8 (VCC)
CHG_OK: Q1.1 (G), Q2.3 (D), R15.2, U6.1 (OUTA), U6.7 (OUTB)
CHG_RAW: D1.1 (IO), D2.2 (A), J2.1 (PROTECTED_5V)
CHG_STAT1_N: R9.2, U5.9 (STAT1); also elsewhere on the board
CHG_STAT2_N: R10.2, U5.3 (STAT2); also elsewhere on the board
COLD_REF: R13.2, R14.1, U6.5 (INB+)
GND: C9.2, C10.2, C11.2, C12.2, C24.2, D1.2 (GND), J1.2 (PACK-), J2.2 (RETURN), Q1.2 (S), Q2.2 (S), R7.2, R8.2, R12.2, R14.2, R17.2, RT1.2, U5.5 (GND), U5.11 (EP), U6.4 (VEE); also elsewhere on the board
HOT_REF: R11.2, R12.1, U6.2 (INA-)
ICHG_SET: R8.1, U5.8 (ISET)
ILIM_SET: R7.1, U5.7 (ILIM/VSET)
SYS: C10.1, C24.1, U5.1 (SYS); also elsewhere on the board
TS_MR: RT1.1, U5.6 (TS/MR), U6.3 (INA+), U6.6 (INB-)

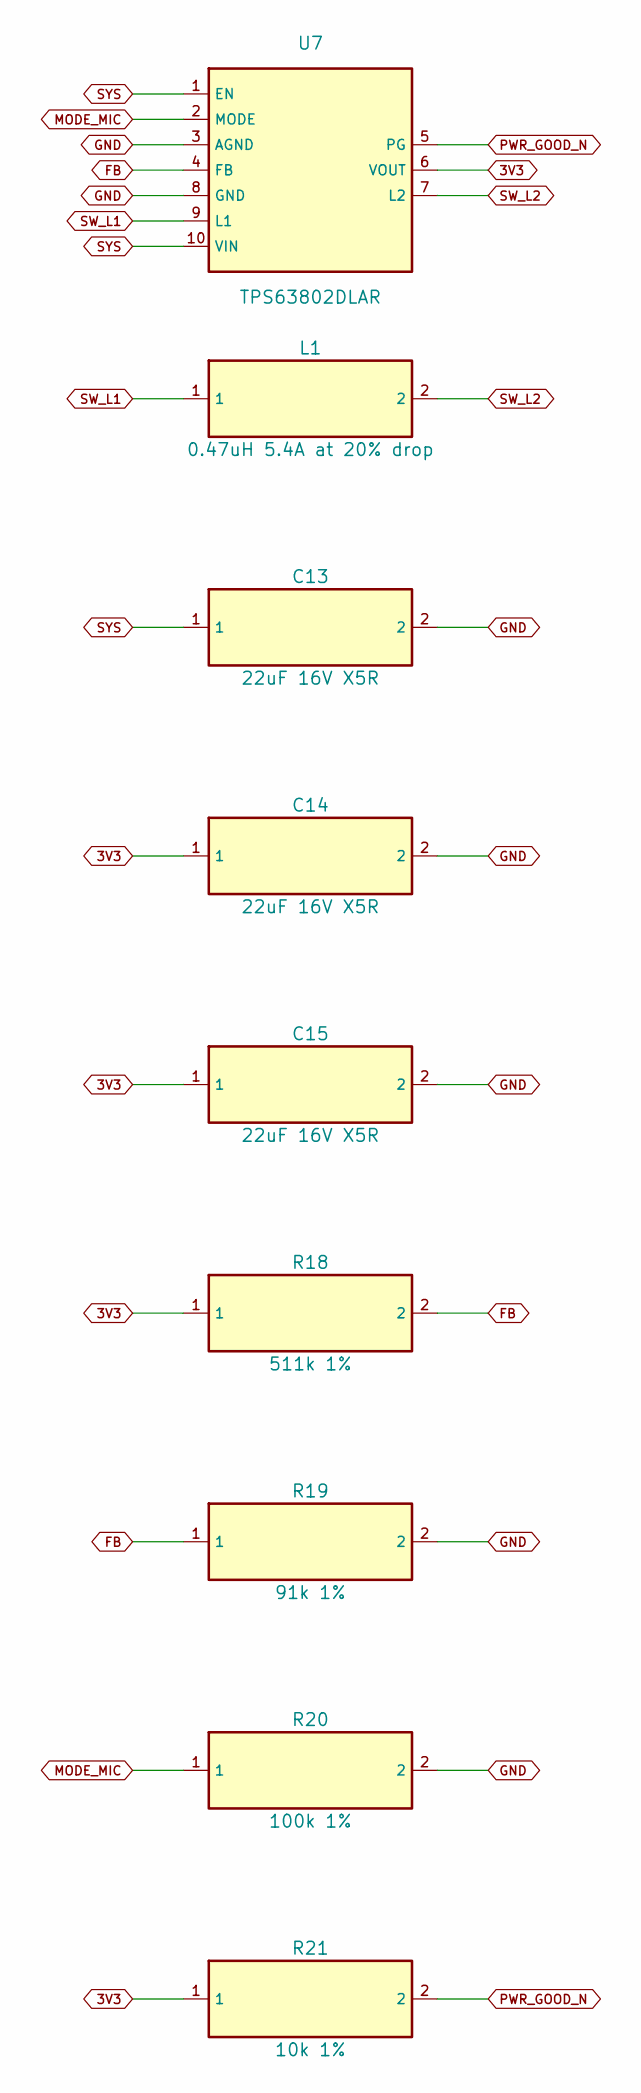
[picture p40: schematic power_regulation.kicad_sch, Power Regulation]

Parts:
C13, C14, C15: 22uF 16V X5R; C_1206_3216Metric; MPN C3216X5R1C226M160AB
L1: 0.47uH 5.4A at 20% drop; L_Coilcraft_XFL4015; MPN XFL4015-471MEC
R18: 511k 1%; R_0603_1608Metric; MPN RC0603FR-07511KL
R19: 91k 1%; R_0603_1608Metric; MPN RC0603FR-0791KL
R20: 100k 1%; R_0603_1608Metric; MPN RC0603FR-07100KL
R21: 10k 1%; R_0603_1608Metric; MPN RC0603FR-0710KL
U7: TPS63802DLAR; Texas_DLA0010A_VSON-10_2x3mm; MPN TPS63802DLAR

Connections:
3V3: C14.1, C15.1, R18.1, R21.1, U7.6 (VOUT); also elsewhere on the board
FB: R18.2, R19.1, U7.4 (FB)
GND: C13.2, C14.2, C15.2, R19.2, R20.2, U7.3 (AGND), U7.8 (GND); also elsewhere on the board
MODE_MIC: R20.1, U7.2 (MODE); also elsewhere on the board
PWR_GOOD_N: R21.2, U7.5 (PG)
SW_L1: L1.1, U7.9 (L1)
SW_L2: L1.2, U7.7 (L2)
SYS: C13.1, U7.1 (EN), U7.10 (VIN); also elsewhere on the board

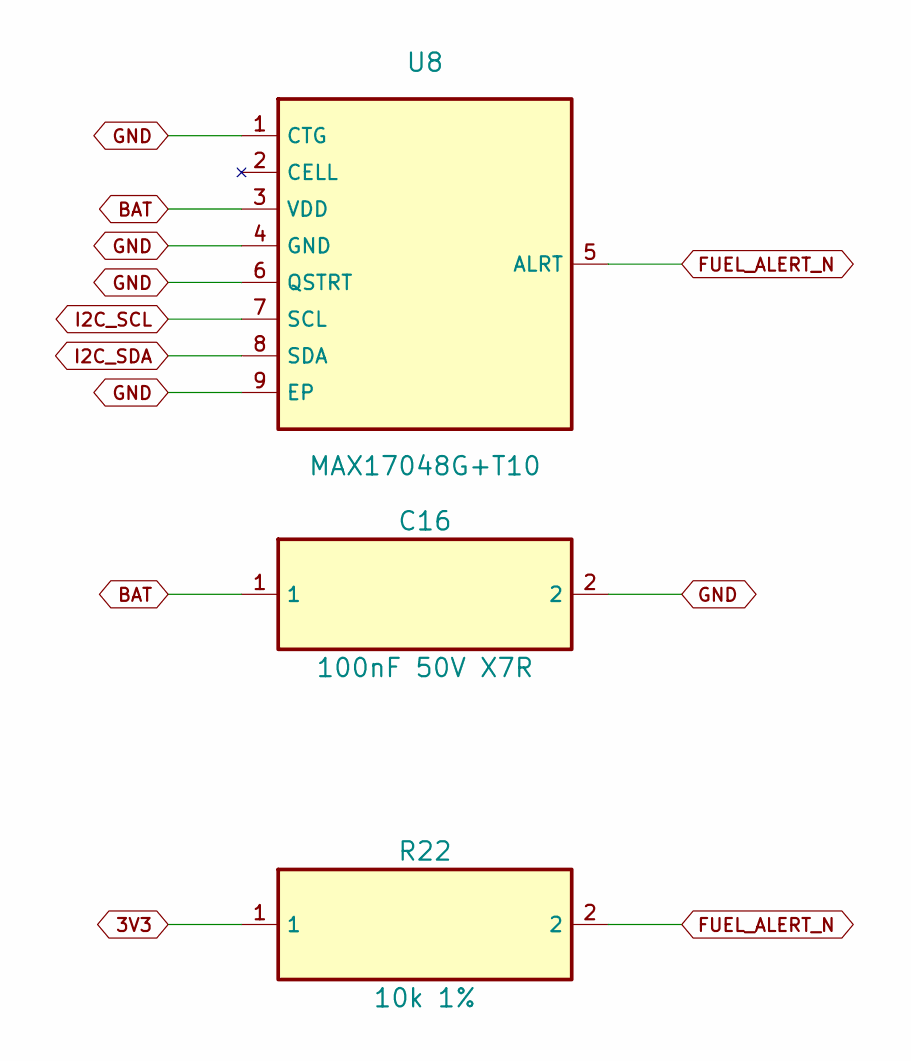
[picture p41: schematic battery_monitoring.kicad_sch, Battery Monitoring]

Parts:
C16: 100nF 50V X7R; C_0603_1608Metric; MPN C1608X7R1H104K080AA
R22: 10k 1%; R_0603_1608Metric; MPN RC0603FR-0710KL
U8: MAX17048G+T10; TDFN-8-1EP_2x2mm_P0.5mm_EP0.8x1.2mm; MPN MAX17048G+T10

Connections:
3V3: R22.1; also elsewhere on the board
BAT: C16.1, U8.3 (VDD); also elsewhere on the board
FUEL_ALERT_N: R22.2, U8.5 (ALRT); also elsewhere on the board
GND: C16.2, U8.1 (CTG), U8.4 (GND), U8.6 (QSTRT), U8.9 (EP); also elsewhere on the board
I2C_SCL: U8.7 (SCL); also elsewhere on the board
I2C_SDA: U8.8 (SDA); also elsewhere on the board

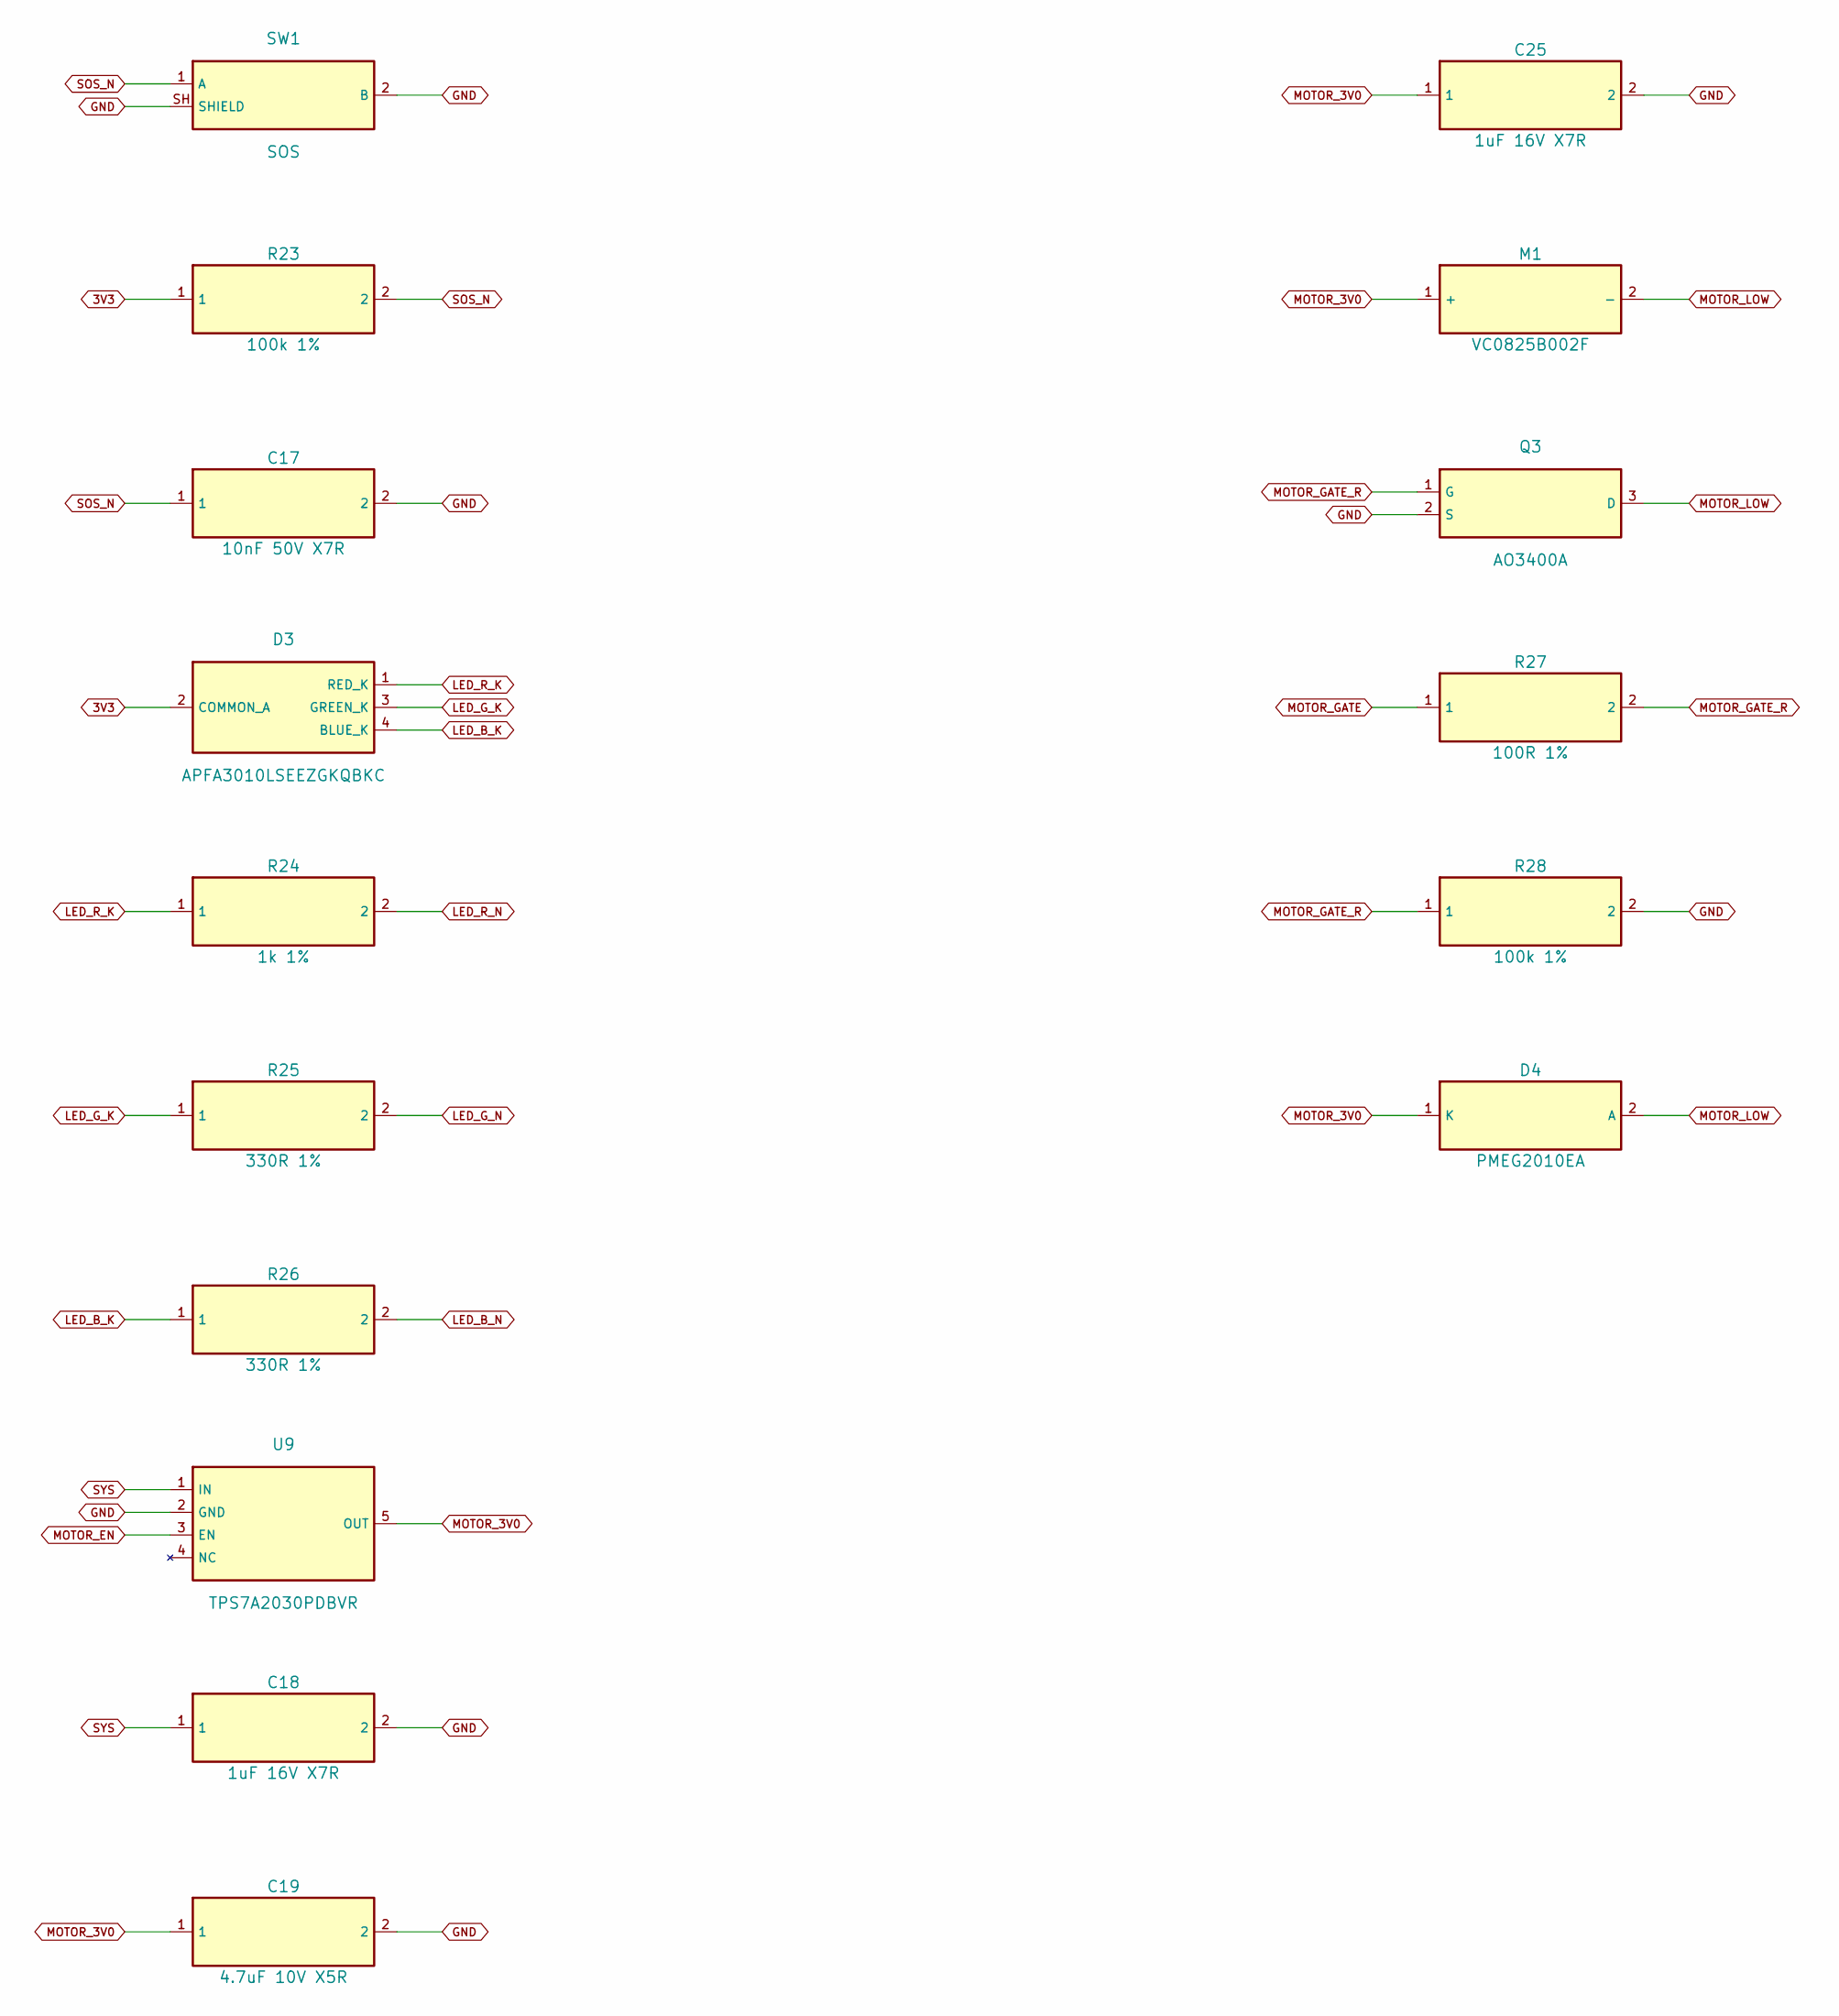
[picture p42: schematic sos_feedback.kicad_sch, Sos Feedback]

Parts:
C17: 10nF 50V X7R; C_0603_1608Metric; MPN C1608X7R1H103K080AA
C18, C25: 1uF 16V X7R; C_0603_1608Metric; MPN C1608X7R1C105K080AC
C19: 4.7uF 10V X5R; C_0603_1608Metric; MPN C1608X5R1A475K080AE
D3: APFA3010LSEEZGKQBKC; LED_Kingbright_APFA3010_3x1.5mm_Horizontal; MPN APFA3010LSEEZGKQBKC
D4: PMEG2010EA; D_SOD-323; MPN PMEG2010EA,115
M1: VC0825B002F; Motor_VC0825B002F; MPN VC0825B002F
Q3: AO3400A; SOT-23; MPN AO3400A
R23, R28: 100k 1%; R_0603_1608Metric; MPN RC0603FR-07100KL
R24: 1k 1%; R_0603_1608Metric; MPN RC0603FR-071KL
R25, R26: 330R 1%; R_0603_1608Metric; MPN RC0603FR-07330RL
R27: 100R 1%; R_0603_1608Metric; MPN RC0603FR-07100RL
SW1: SOS; SW_Push_1P1T-SH_NO_CK_KMR2xxG; MPN KMR231GLFS
U9: TPS7A2030PDBVR; SOT-23-5; MPN TPS7A2030PDBVR

Connections:
3V3: D3.2 (COMMON_A), R23.1; also elsewhere on the board
GND: C17.2, C18.2, C19.2, C25.2, Q3.2 (S), R28.2, SW1.2 (B), SW1.SH (SHIELD), U9.2 (GND); also elsewhere on the board
LED_B_K: D3.4 (BLUE_K), R26.1
LED_B_N: R26.2; also elsewhere on the board
LED_G_K: D3.3 (GREEN_K), R25.1
LED_G_N: R25.2; also elsewhere on the board
LED_R_K: D3.1 (RED_K), R24.1
LED_R_N: R24.2; also elsewhere on the board
MOTOR_3V0: C19.1, C25.1, D4.1 (K), M1.1 (+), U9.5 (OUT)
MOTOR_EN: U9.3 (EN); also elsewhere on the board
MOTOR_GATE: R27.1; also elsewhere on the board
MOTOR_GATE_R: Q3.1 (G), R27.2, R28.1
MOTOR_LOW: D4.2 (A), M1.2 (-), Q3.3 (D)
SOS_N: C17.1, R23.2, SW1.1 (A); also elsewhere on the board
SYS: C18.1, U9.1 (IN); also elsewhere on the board
