balu-16/SeedGrant_Safety/smart-safety-tag-v1/hardware/tag/smart-safety-tag.kicad_pcb

## KiCad design smart-safety-tag-v1/hardware/tag/smart-safety-tag.kicad_pcb (continued)

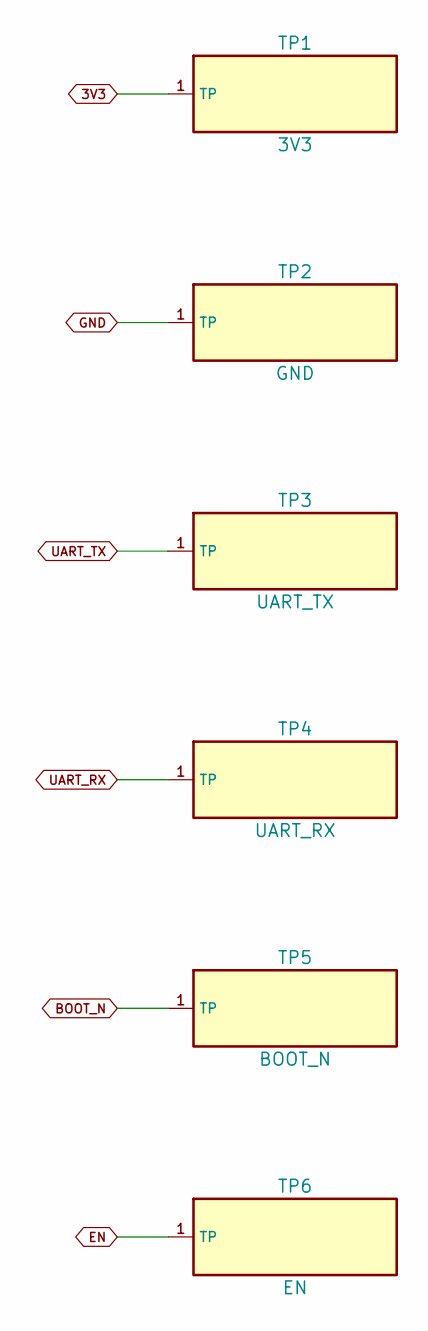
[picture p43: schematic programming_protection.kicad_sch, Programming Protection]

Parts:
TP1: 3V3; TestPoint_Pad_D1.0mm
TP2: GND; TestPoint_Pad_D1.0mm
TP3: UART_TX; TestPoint_Pad_D1.0mm
TP4: UART_RX; TestPoint_Pad_D1.0mm
TP5: BOOT_N; TestPoint_Pad_D1.0mm
TP6: EN; TestPoint_Pad_D1.0mm

Connections:
3V3: TP1.1; also elsewhere on the board
BOOT_N: TP5.1; also elsewhere on the board
EN: TP6.1; also elsewhere on the board
GND: TP2.1; also elsewhere on the board
UART_RX: TP4.1; also elsewhere on the board
UART_TX: TP3.1; also elsewhere on the board

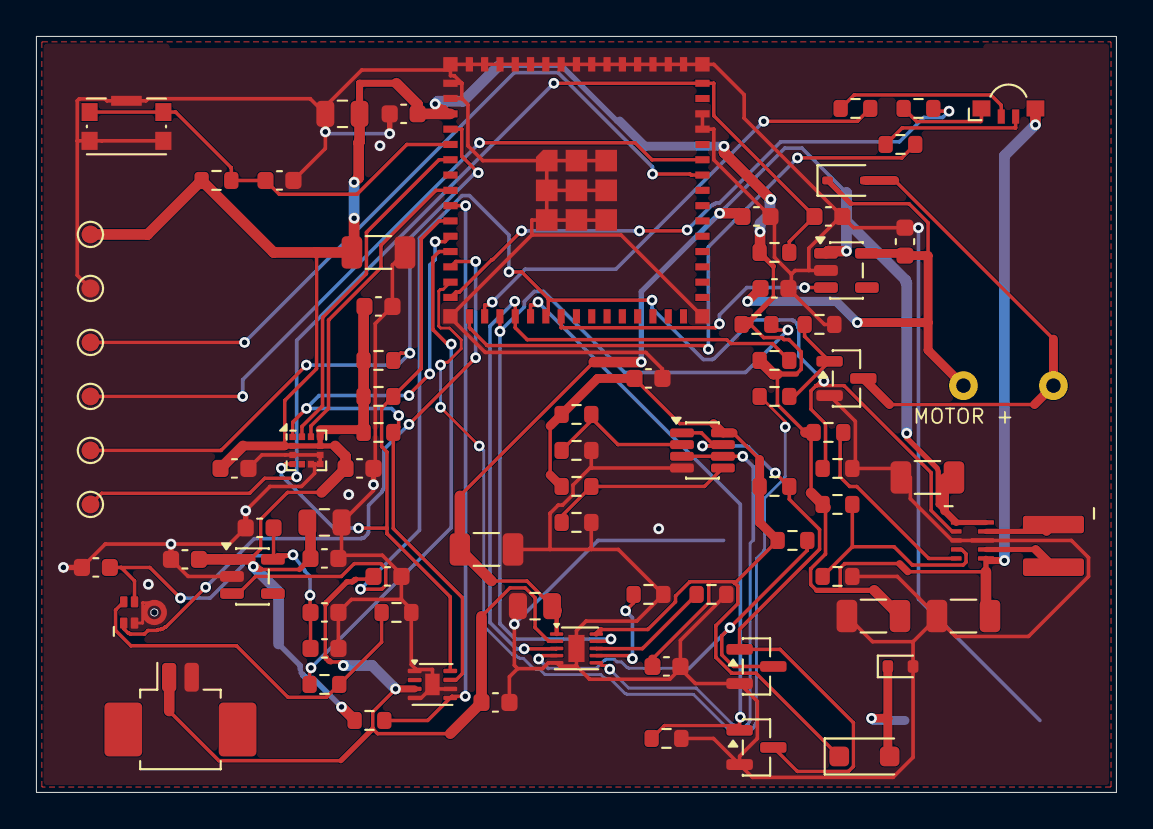
[picture p44: board smart-safety-tag.kicad_pcb from above]

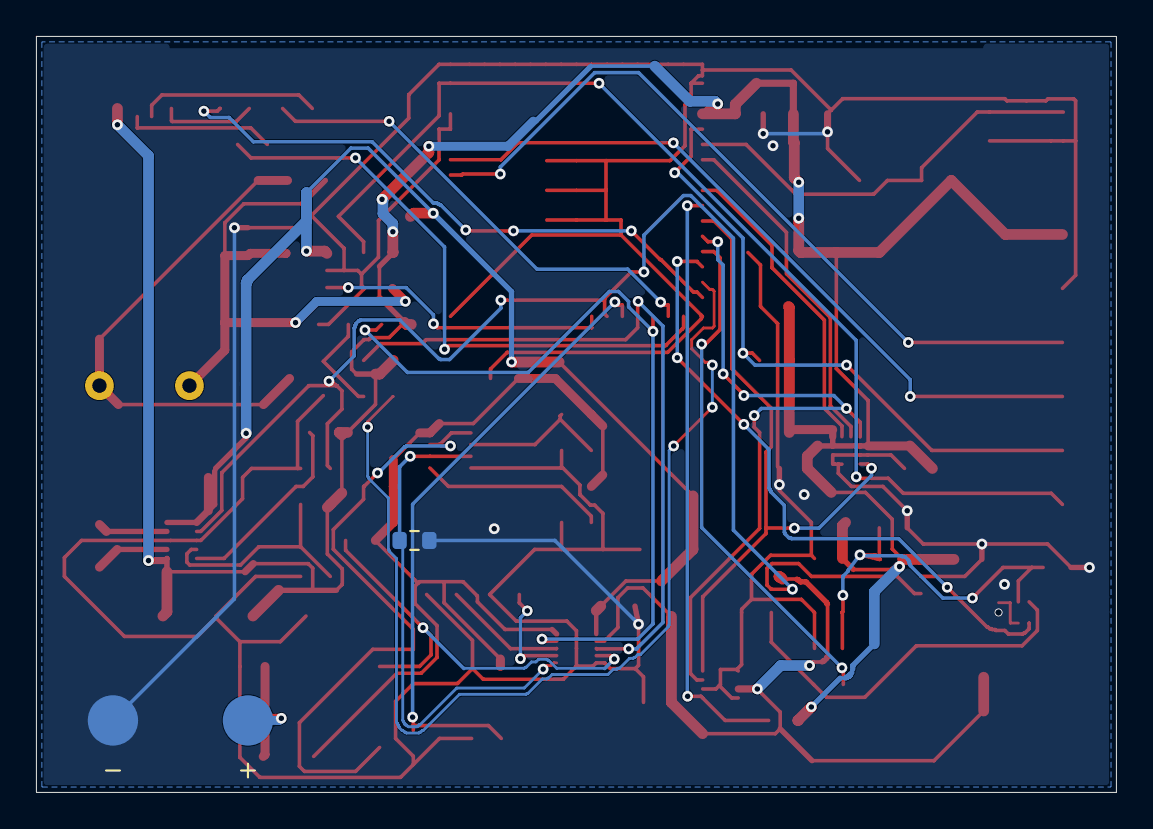
[picture p45: board smart-safety-tag.kicad_pcb from below]

Board: 2 copper layers, 60.0 x 42.0 mm, 83 parts (2 on the bottom side), 46 nets.
