balu-16/SeedGrant_Safety/smart-safety-tag-v1/hardware/charging-adapter/charging-adapter.kicad_pcb

## KiCad design smart-safety-tag-v1/hardware/charging-adapter/charging-adapter.kicad_pcb (2026-09-29)

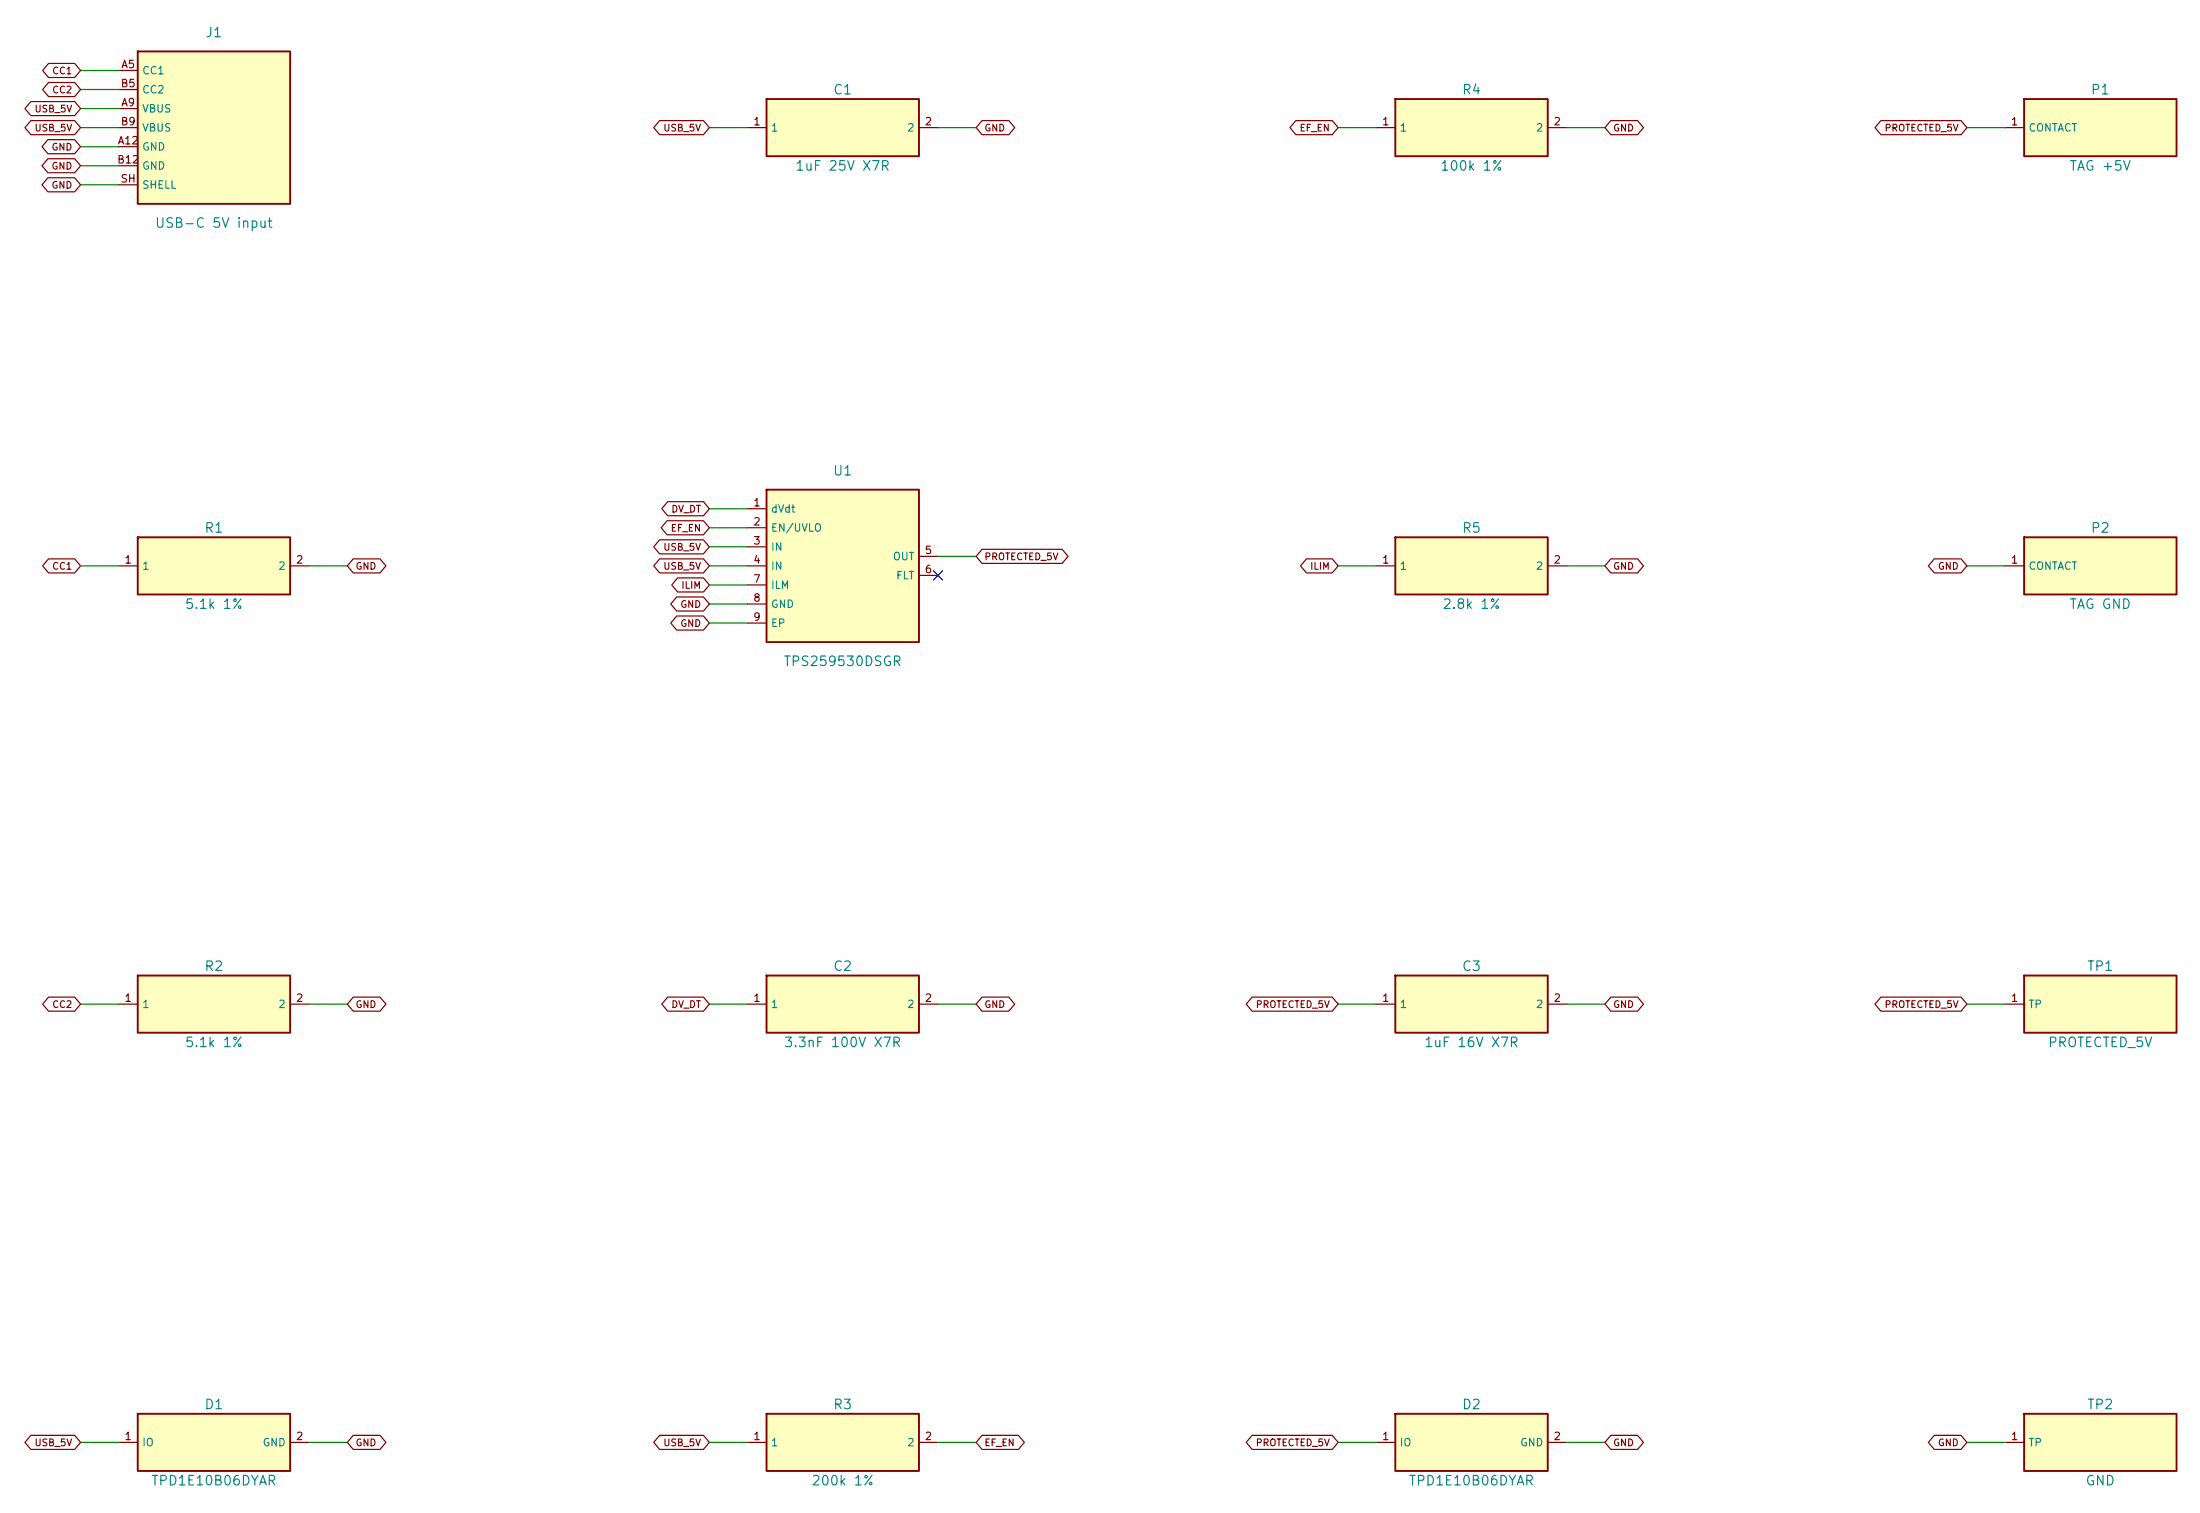
[picture p46: schematic charging-adapter.kicad_sch, Smart Safety Tag 5V Charging Fixture]

Parts:
C1: 1uF 25V X7R; C_0603_1608Metric; MPN C1608X7R1E105K080AE
C2: 3.3nF 100V X7R; C_0603_1608Metric; MPN C1608X7R2A332K080AA
C3: 1uF 16V X7R; C_0603_1608Metric; MPN C1608X7R1C105K080AC
D1, D2: TPD1E10B06DYAR; D_SOD-523; MPN TPD1E10B06DYAR
J1: USB-C 5V input; USB_C_Receptacle_GCT_USB4125-xx-x_6P_TopMnt_Horizontal; MPN USB4125-GF-A
P1: TAG +5V; PogoPin_MillMax_0900-1; MPN 0900-1-15-20-75-14-11-0
P2: TAG GND; PogoPin_MillMax_0900-1; MPN 0900-1-15-20-75-14-11-0
R1, R2: 5.1k 1%; R_0603_1608Metric; MPN RC0603FR-075K1L
R3: 200k 1%; R_0603_1608Metric; MPN RC0603FR-07200KL
R4: 100k 1%; R_0603_1608Metric; MPN RC0603FR-07100KL
R5: 2.8k 1%; R_0603_1608Metric; MPN RC0603FR-072K8L
TP1: PROTECTED_5V; TestPoint_Pad_D1.0mm
TP2: GND; TestPoint_Pad_D1.0mm
U1: TPS259530DSGR; Texas_DSG0008A_WSON-8-1EP_2x2mm_P0.5mm_EP0.9x1.6mm; MPN TPS259530DSGR

Connections:
CC1: J1.A5 (CC1), R1.1
CC2: J1.B5 (CC2), R2.1
DV_DT: C2.1, U1.1 (dVdt)
EF_EN: R3.2, R4.1, U1.2 (EN/UVLO)
GND: C1.2, C2.2, C3.2, D1.2 (GND), D2.2 (GND), J1.A12 (GND), J1.B12 (GND), J1.SH (SHELL), P2.1, R1.2, R2.2, R4.2, R5.2, TP2.1, U1.8 (GND), U1.9 (EP)
ILIM: R5.1, U1.7 (ILM)
PROTECTED_5V: C3.1, D2.1 (IO), P1.1, TP1.1, U1.5 (OUT)
USB_5V: C1.1, D1.1 (IO), J1.A9 (VBUS), J1.B9 (VBUS), R3.1, U1.3 (IN), U1.4 (IN)

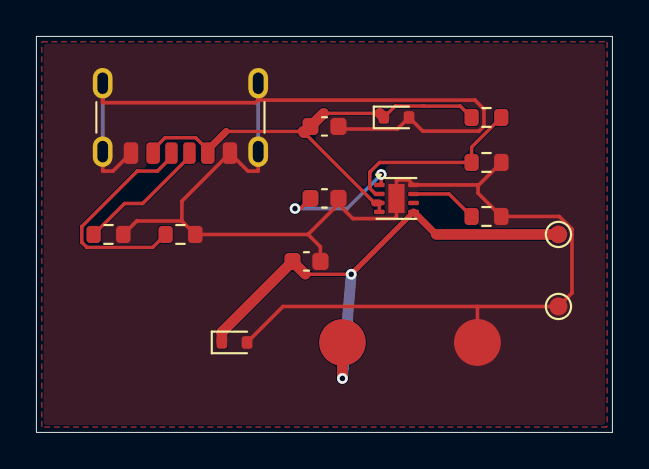
[picture p47: board charging-adapter.kicad_pcb from above]

Board: 2 copper layers, 32.0 x 22.0 mm, 16 parts (0 on the bottom side), 8 nets.
