balu-16/SeedGrant_Safety/smart-safety-tag-v1/firmware/hardware-tests/main/board_pins.h

/* Generated from hardware/board-interface.json and audited against the MCU symbol. */
#pragma once

#define PIN_SOS_N 1
#define PIN_ACCELEROMETER_INT1 2
#define PIN_ACCELEROMETER_INT2 4
#define PIN_FUEL_ALERT_N 5
#define PIN_I2C_SDA 6
#define PIN_I2C_SCL 7
#define PIN_PDM_CLK 8
#define PIN_PDM_DATA 9
#define PIN_MOTOR_GATE 10
#define PIN_LED_RED_N 11
#define PIN_LED_GREEN_N 12
#define PIN_LED_BLUE_N 13
#define PIN_CHARGER_STAT1_N 14
#define PIN_CHARGER_STAT2_N 15
#define PIN_CHARGE_INHIBIT 16
#define PIN_REGULATOR_MODE 17
#define PIN_MOTOR_SUPPLY_ENABLE 18
#define PIN_UART0_TX 43
#define PIN_UART0_RX 44
#define PIN_BOOT 0

#define AUDIO_PCM_RATE_HZ 16000
#define AUDIO_PDM_CLOCK_HZ 2048000
