balu-16/SeedGrant_Safety/(commit log)

2026-09-13 Harden server: rate limits, fail-closed JWT, consent flow, background SOS, dead code
    Security:
    - In-memory sliding-window rate limits (register 5/min, login 10/min,
    refresh 60/min, SOS create 10/min) with 429 rate_limited responses
    - Refuse to start in production-like ENV with the default JWT_SECRET;
    restrict jwt_algorithm to symmetric HS*; CORS credentials disabled
    for wildcard origins
    - Refresh-token rotation is now single-use (honors the conditional
    revoke result), closing the double-spend race
    - Registration no longer 500s: whitespace-only name/phone rejected (422)
    and concurrent duplicate emails return 409
    Reliability:
    - FCM push fan-out for SOS runs as a background task afte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
2026-09-13 Fix client integration blockers: remote auth, session restore, WS reconnect, guardian sync
    - Auth now targets the real API whenever EXPO_PUBLIC_API_URL is set,
    including pre-login (getAuthServices) — remoteAuth was previously
    unreachable from the UI, so the app could never sign in against the
    backend and kept firing token-less API calls after mock login
    - Background refresh emits session events: hooks reconnect the realtime
    socket and re-register push tokens when a token is restored (fixes
    dead WS/push after app restart), and a rejected refresh drops the
    signed-in UI state instead of leaving a zombie session
    - WebSocket reconnect re-reads the current access token on every retry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
